Butylochnik/Nedra_Sarai/sarai_v1_content_dxf.odt

# Зміст аркушів креслень

1. Загальний вигляд.
2. Розріз А-А. Фундамент.
3. Розріз А-А. Лицювання фундаменту, відмостка. (немає)
4. Підвал.
5. Покрівна плита підвалу.
6. Оглядова яма.
7. Розріз Б-Б. Низ коробки.
8. Розріз В-В. Середина коробки.
9. Розріз Г-Г. Верх коробки.
10. ЗБ перекриття.
11. Вікно кімнатне звичайне.
12. Вікно кімнатне світлове.
13. Двері кімнатні.
14. Перемичка дверна (розріз).
15. Ворота гаражні.
16. Перемичка воріт (розріз).
17. Загальна перемичка воріт.
18. Армопояс ЗБ перекриття.
19. Арматурні каркаси вікон (додаток до арк. 11, 12).
20. Розрізи армопоясу у різних місцях (додаток до арк. 9).
21. Модифіковані U-блоки.
22. Розрізи армопоясу ЗБ перекриття у різних місцях (додаток до арк. 18).
23. Кроквяна система (розріз).
24. Кроквяна система (план).
25. Крокви (креслення).
26. Фронтон.
27. Вікно дахове.
28. Вікно слухове.
29. Розкладка дощок решетування.
30. Розкладка шиферу.
31. Димар.
