Butylochnik/Nedra_Sarai/sarai_notes.odt

# Кладка

Кладка всіх стін крім перегородки IV виконується з газоблоків AEROC розміром (Д х Ш х В) 60 см х 30 см х 20 см. Кладка перегородки IV виконується з газоблоків AEROC розміром 60 см х 40 см х 20 см.

Зовні стіни лицюються керамічною цеглою стандартних розмірів 25 см х 12,5 см х 6,5 см. Відстань між облицовкою і основною стіною 4,5 см.

Основна стіна і облицовка зв’язуються гнучкими зв’язками, виконаними з металевої оцинкованої штапи завтовшки не менше 0,5 мм і завширшки 5 ... 6 см. Штапи вставляються через кожні 3 ряди кладки основної стіни (60 см) на відстані 80 ... 120 см одна від одної.

Лицювальна цегла вкладається з вентиляційними отворами, виконаними як вертикальні шви, що не заповнені розчином. Кількість вентиляційних отворів 4 ... 5 на 1 м² кладки. Вентиляційні отвори не влаштовуються у 4 верхніх рядах кладки.

У першому ряді лицювальної кладки через кожні 3 цегли робляться дренажні отвори, виконані як вертикальні шви, що не заповнені розчином.

Кути виконуються згідно Малюнок 1. Виступ декоративних кутів і пояска 2...3 см відповідно до розміру декоративної частини цегли.

2..3

A

Вигляд A

Малюнок 1. Виконання кутів.
