Butylochnik/Nedra_Sarai/SolarStation/Nedra_Sarai_SolarStation.odt

# Розрахунок архітектури системи (версія 2)

### Склад:

1. Сонячна батарея Risen RSM40-8-400M (9 шт.);
2. Акумуляторна батарея TOYAMA NPS100-12 (4 шт.);
3. Гібридний інвертор Must Power Systems PH18 MPPT 5048/60A (1 шт.);
4. Пристрій захисту від імпульсних завад ОПС1-С 1P клас II (C), IEK (4 шт.);
5. Автоматичний вимикач ВА47-60 2P 16 А х-ка C, IEK (3 шт.);
6. Автоматичний вимикач ВА47-60 2P 25 А 30 мА хар-ка B тип AC, IEK (1 шт.):
7. Плавка вставка запобіжника ППНИ-33, габарит 00, 160 А, IEK (1 шт);
8. Вимикач-роз'єднувач під запобіжники e.fuse.VR.160, 3P габарит 00, 160А, E.NEXT (1 шт).

### Параметри компонентів:

1. Сонячна батарея (1 модуль):
  1. Макс. потужність, (Вт) 400
  2. Напруга за макс. потужності, (В) 34.39
  3. Струм за макс. потужності, (А) 11.64
  4. Струм к.з., (А) 12.34
  5. Напруга х.х., (В) 41.3
2. Акумуляторна батарея (1 модуль):
  1. Ємність, (А * год) 100
  2. Напруга, (В) 12
  3. Ном. зарядний струм, (А) 10
3. Інверторний модуль:
  1. Макс. потужність сон. панелей, (Вт) 3000
  2. Макс. зарядний струм сон. панелей, (А) 80
  3. Макс. зарядний струм від мережи, (А) 60
  4. Роб. діапазон MPPT PV, (В) 64 ~ 130
  5. Макс. напруга х.х. PV масива, (В) 145

### Архітектура системи.

NPS
100-12

Ext. Line

Int. Line

Fuse 160A

OverC prot.
16A

OverV prot.

OverV prot.

1

4

2

2

2

PH18 MPPT 5048/60A

AC In
~ ~

AC Out
~ ~

ACC
+ -

PV Arr
+ -

3

NPS
100-12

NPS
100-12

NPS
100-12

4

5

6

RSM40-8-400M

OverCprot.
25A

RSM40-8-400M

RSM40-8-400M

RSM40-8-400M

RSM40-8-400M

RSM40-8-400M

RSM40-8-400M

RSM40-8-400M

RSM40-8-400M

8

1. Напруга х.х. на сонячних батареях: 41.3 * 3 = 123.9 < 145.
2. Напруга на сонячних батареях за макс. потужності: 34.39 * 3 = 103.17 < 130.
3. Струм к.з. сонячних батарей: 12.34 * 3 = 37.02; Дріт 8AWG (∅ 3.3, S 8.37 mm²).
4. Струм від сонячних батарей за макс. потужності 11.64 * 3 = 34.92.
5. Максимальна потужність сонячних батарей 400 * 9 = 3600.
6. Струм від акумулятора на номінальній. потужності: (4000 + 50) / 48 = 84.4; Дріт 4AWG (∅ 5.2, S 21.2 mm²).
7. Струм від акумулятора на макс. потужності (5 сек):

(2 * 4000 + 50) / 48 = 167.7

# Проблеми, що можуть виникнути

1. Сонячні панелі можуть намагатися пошкодити, кинувши каміння.
2. Удар блискавки в панелі.

# Комунікація

Відповідь lsusb при підключеному і відключеному інверторі:

butylochnik@john-Inspiron-7347:~$ lsusb

Bus 001 Device 003: ID 0a5c:216a Broadcom Corp.

Bus 001 Device 002: ID 8087:8000 Intel Corp.

Bus 001 Device 001: ID 1d6b:0002 Linux Foundation 2.0 root hub

Bus 003 Device 001: ID 1d6b:0003 Linux Foundation 3.0 root hub

Bus 002 Device 005: ID 04f3:042f Elan Microelectronics Corp.

Bus 002 Device 004: ID 0c45:64cb Microdia

Bus 002 Device 003: ID 0483:91d1 STMicroelectronics Sensor Hub

Bus 002 Device 002: ID 09da:054f A4Tech Co., Ltd.

Bus 002 Device 006: ID 1a86:7523 QinHeng Electronics HL-340 USB-Serial adapter

Bus 002 Device 001: ID 1d6b:0002 Linux Foundation 2.0 root hub

butylochnik@john-Inspiron-7347:~$ lsusb

Bus 001 Device 003: ID 0a5c:216a Broadcom Corp.

Bus 001 Device 002: ID 8087:8000 Intel Corp.

Bus 001 Device 001: ID 1d6b:0002 Linux Foundation 2.0 root hub

Bus 003 Device 001: ID 1d6b:0003 Linux Foundation 3.0 root hub

Bus 002 Device 005: ID 04f3:042f Elan Microelectronics Corp.

Bus 002 Device 004: ID 0c45:64cb Microdia

Bus 002 Device 003: ID 0483:91d1 STMicroelectronics Sensor Hub

Bus 002 Device 002: ID 09da:054f A4Tech Co., Ltd.

Bus 002 Device 001: ID 1d6b:0002 Linux Foundation 2.0 root hub

butylochnik@john-Inspiron-7347:~$

# Перелік робіт

№ | Операція | Матеріали | Інструмент | Ризики і шляхи обходу | ✓
1 | Складання допоміжного трапу. | Дошка 25 × 150 × 4000 1 шт, дошка 25 × 150 × 2000 1 шт, рейка 30 × 30 × 3000 1 шт, мет. кутник 2 шт, шуруп ∅ 5 × 50 100 шт. | Рулетка, дриль, жало-викрутка, пила, викрутка хрестова. | | ✓
2 | Натягування горизонтальних мотузок. | Мотузка, цвяхи. | Рулетка, молоток. | Місце кріплення може не потрапити в дошку. Переконатися, що мотузка йде по центру дошки. | Не робилось
3 | Розмітка місць кріплення кронштейнів. | | Рулетка, крейда.
4 | Свердління отворів під шпильки кронштейнів. Встановлення шпильок і кронштейнів. | Шпилька Шпилька дворізьбова гвинт-шуруп 8x120 16 шт, гайка М8 32 шт, шайба гровера 16 шт, герметик. | Свердла ∅ 8, ∅ 5 (довге), набір торцевих накидних ключів, ріжкові ключі. | | ✓
5 | Свердління отворів під заземлення в рейках. | | Свердло ∅ 8, дриль. | | ✓
6 | Встановлення рейок для сонячних батарей. | | Набір ключів торцевих внутрішніх, мотузка. | Не забути передбачити приєднання заземлення. | ✓
7 | Виготовлення тримачів для батарей | Залізо 2 мм. | Рулетка, болгарка, лещата. | | Не робилось
8 | Виготовлення дротів підключення сонячних батарей і дротів заземлення. | Кабель ∅ 3.3, роз'єми, термозбіжка, олово, каніфоль. | Рулетка, паяльник 100 Вт, викрутка, кусачки. | Перед монтажем другого роз'єму надіті на дріт шматок термоусадки. | ✓
9 | Встановлення сонячних батарей. | Кріплення для батарей, дроти підключення. | Набір ключів торцевих внутрішніх, вольтметр. | Забуті або некоректні з'єднання. Перевірити: з кожного боку до дротів підключення приєднані однакові полюси; всі батареї з'єднані. заземлення підключене до обох рейок. Всі дроти на поверхні даху у пластикових трубках. | ✓
10 | Встановлення розподільчих коробок на даху. | Розподільчі коробки, шурупи | Хрестова викрутка, шило | Одну з коробок треба купити. | ✓
11 | Свердління отворів для дротів підключення до інвертора. | | Перфоратор (дриль), бур (свердло) | | ✓
12 | Виготовлення дротів підключення сонячних батарей до інвертора і дроту заземлення сонячних батарей. | Кабелі S 10, S 6, клеми, термозбіжка, олово, каніфоль. | Рулетка, паяльник 200 Вт, кусачки. | Перед монтажем другого роз'єму надіті на дріт шматок термозбіжки. | ✓
13 | Підключення і прокладка робочих дротів і дроту заземлення. | Гофрована пластикова трубка, гвинти з гайками і шайбами гровера М8, (колодка клемна 10 мм²), хомути. | Гайкові ключі, викрутки. | | ✓
14 | Виготовлення дротів підключення акумулятора до інвертора. | Кабель S 25, клеми, термозбіжка, олово, каніфоль. | Рулетка, паяльник 200 Вт, кусачки. | Перед монтажем другого роз'єму надіті на дріт шматок термозбіжки. Один з дротів має йти через запобіжник. | ✓
15 | Виготовлення тимчасового стелажу для акумуляторів | Рейки, дошки, шурупи. | Пилка, дриль з викруткою. | | ✓
16 | Монтаж інвертора на стіну. | Дюбелі ∅ 10 3 шт, шурупи ∅ 8 3 шт. | Перфоратор, бур, молоток, гайковий ключ. | | ✓
17 | Монтаж кабельних каналів. | Дюбелі ∅ 5, шурупи ∅ 3, кабельний канал. | Перфоратор, бур, молоток, хрестова викрутка. | | ✓
18 | Монтаж коробки для автоматів та ПЗІП | Дюбелі ∅ 8, шурупи ∅ 4, коробка ПЗІП. | Перфоратор, бур, молоток, хрестова викрутка. | | ✓
19 | Монтаж коробки і запобіжника | Дюбелі ∅ 10, шурупи ∅ 6, коробка і кронштейн для запобіжника. | Перфоратор, бур, молоток, хрестова викрутка. | Попередньо коробку підігнати під запобіжник. | ✓
20 | Монтаж та підключення до інвертора акумуляторів. | Дроти, запобіжник. | Гайковий ключ. | Перевірити полярність. Дроти пропустити через кришку інвертора. | ✓
21 | Монтаж та підключення до інвертора і батарей автоматів та ПЗІП. | Дроти. | Хрестова викрутка, паяльник, олово, каніфоль. | | ✓
22 | Підключення до інвертора заземлення. | | Хрестова викрутка. | | ✓
23 | Перевірка працездатності системи. | Розетка-подовжувач. | Хрестова викрутка, тестер. | Перевірка роботи: лампочки, холодильника, чайника. | ✓

# Комерційні данні

# Висновки

- Систему було запущено у використання 10/08/23.
- Спочатку було підключено інвертор разом із акумуляторами до зовнішньої і внутрішньої мереж. В такому режимі інвертор використовувався як UPS починаючи з грудня 2022. Вже в липні було монтовано батареї і підключено до інветора.
- Всі роботи монтажу рейок і дротів велися безпосередньо з підставленої до краю даху драбини а потім із вже встановлених рейок.
- Підйом батарей на дах здійснювався по 2х рейках, з’єднаних між собою. Рейки використовував довжиною близько 6 м, що забезпечило легкий підйом батарей.
- Верхній ряд батарей монтувався з нижніх рейок. Для монтажу нижнього ряду у верхній частині рейок прикрутив горизонтальний трап, по якому пересувався коли виставляв батарею.
- В самих батареях, які ставив у нижній ряд, вкрутив у верхній частині з кожного боку по гвинту (отвори в батареях вже були). Після підйому батарея цими гвинтами чіплялась до верхньої монтажної планки. Це дозволило легко переміщатися в нижню частину батареї після її підйому.
- Для приєднання до батарей на поверхні даху використав спеціальний дріт KBE solar 4 мм². Решту розводки робив кабелем ПВ-3 10 мм². Для заземлення використав ПВ-3 6 мм².
- Автомати відключення батарей так само як і ПЗІПи було встановлено на даху. Через необхідність захисту як плюса так і мінуса сонячного масиву було використано двох полюсні автомати біля інвертора встановлено автомат (теж двох полюсний) відключення від мережі і відповідні ПЗІПи.

# Розрахунок потужності для зварювального апарату

1. Максимальна потужність (ККД = 0.95):
  1. 150 * 26 / 0.95 = 4.1 кВт.
  2. Це відповідає мережевому струму 150 * 26 / (0.95 * 220) = 18.7 А.

# Спостереження за роботою системи

Майже одразу після встановлення сонячних батарей помітив аномальну поведінку системи — інвертор регулярно клацав якоюсь релюхою. Визначити причину такої аномалії довго не вдавалося. На початку 06.2024 з'ясував, що один з акумуляторів вийшов з ладу — напруга на ньому в режимі заряджання могла сягати 18 В, а під навантаженням могла падати до 6 В. Замінив цей акумулятор на автомобільний і система повернулася до нормального стану. Отже замовив аналогічний за параметрами акумулятор https://mega-teplo.com.ua/ua/p1979176844-gelevij-akumulyator-toyama.html і 09.06.24 ввів в експлуатацію.

Максимальний струм, який інвертор подає для зарядки акумуляторів, виглядає суттєво завищеним — 60 А проти 30 А, на які розраховані акумулятори. Експериментально встановив, що цим струмом опікується параметр за номером 02 у списку параметрів інвертора. Встановив його на рівні 10 А (1/10 від ємності акумулятора).

Виглядає так, що параметр за номером 47 у списку параметрів сонячного перетворювача не має відношення до струму зарядки батарей а визначає максимальний струм, який видаватиме цей блок на внутрішню шину.

Подальші спостереження показали, що параметр 02 визначає не тільки струм заряду батарей але (так само як і параметр 47) й той струм, який сонячний перетворювач видає на внутрішню шину. Отже щоб відбирати максимальну енергію від батарей потрібно цей параметр встановити на рівні 60 або, навіть, 70 А. Так і не зрозумілим залишається чим тоді обмежувати максимальний зарядний струм батарей?

Купив додатково 4 акумулятори такого самого типу, як встановив 09.06.24: https://toyama.com.ua/product/toyama-npg-100a-12v-gel/. Сконструював полицю для 8 акумуляторів (https://github.com/Butylochnik/Misc_Const/blob/main/Stoika_akumiv.dxf) і 16.07.24 підключив паралельно 2 гірлянди по 4 акумулятори збільшивши ємність батареї до 200 Аг. Також в параметрах інвертора поміняв ємність акумулятора на 200 Аг.
