Butylochnik/Nedra_Sarai/Sarai/sarai_chronicle.odt

21.10.20 Сьогодні розпочали будівництво. Розмітили і на 20 см прокопали майбутній фундамент. Забудовник — Сашко Кіндратюк з Березані (тел. +380 97 340 40 85).

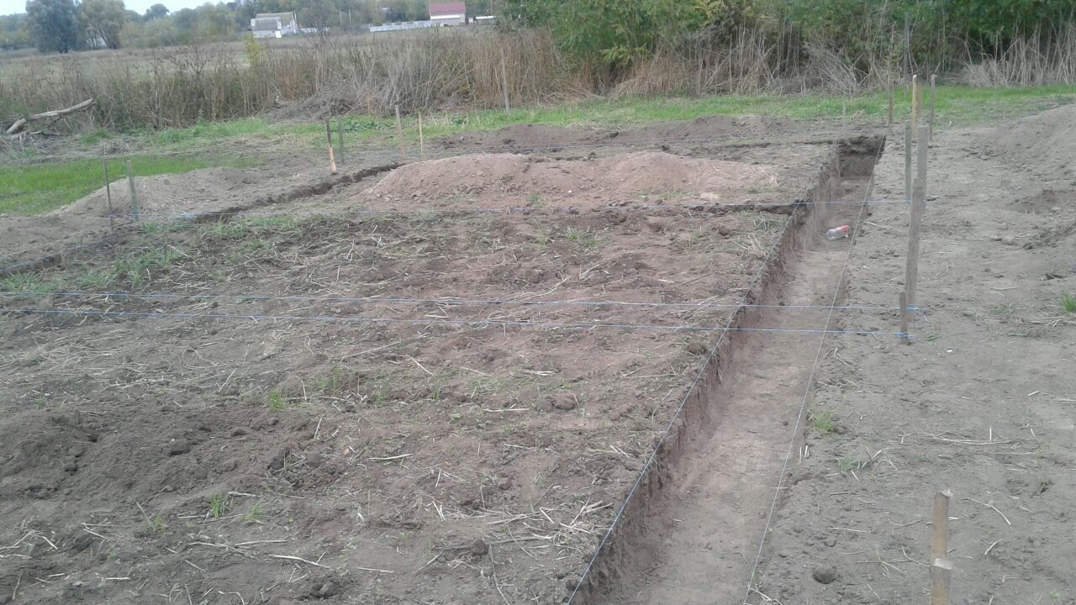
[picture p1: figure]
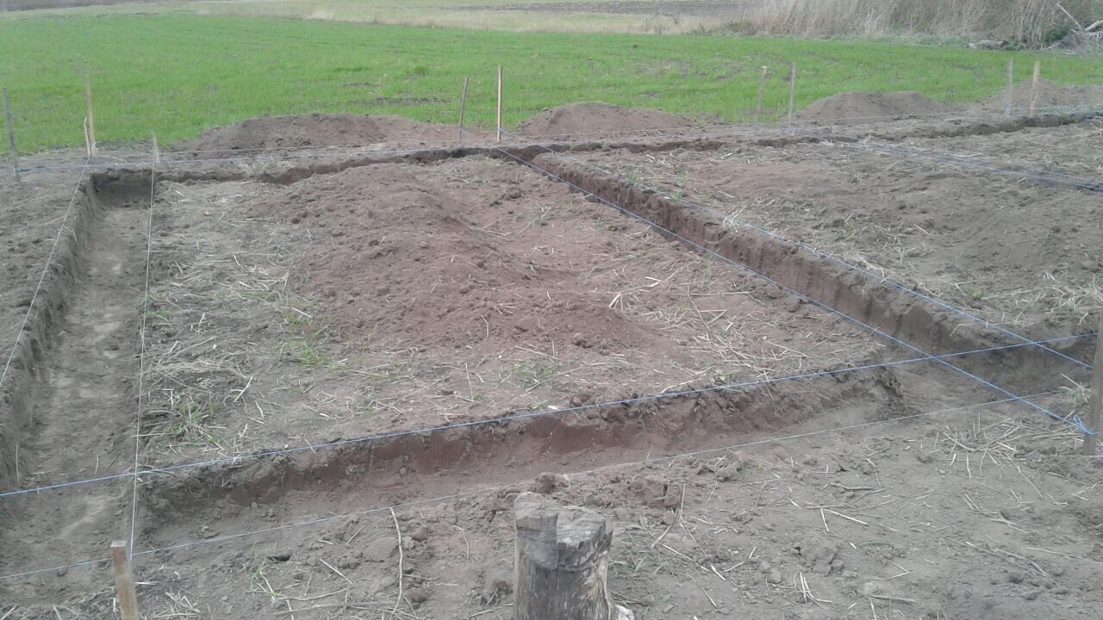
[picture p2: figure]

23.10.20 Закінчили копати траншею під фундамент. Траншея глибиною скрізь 1 м від поверхні.

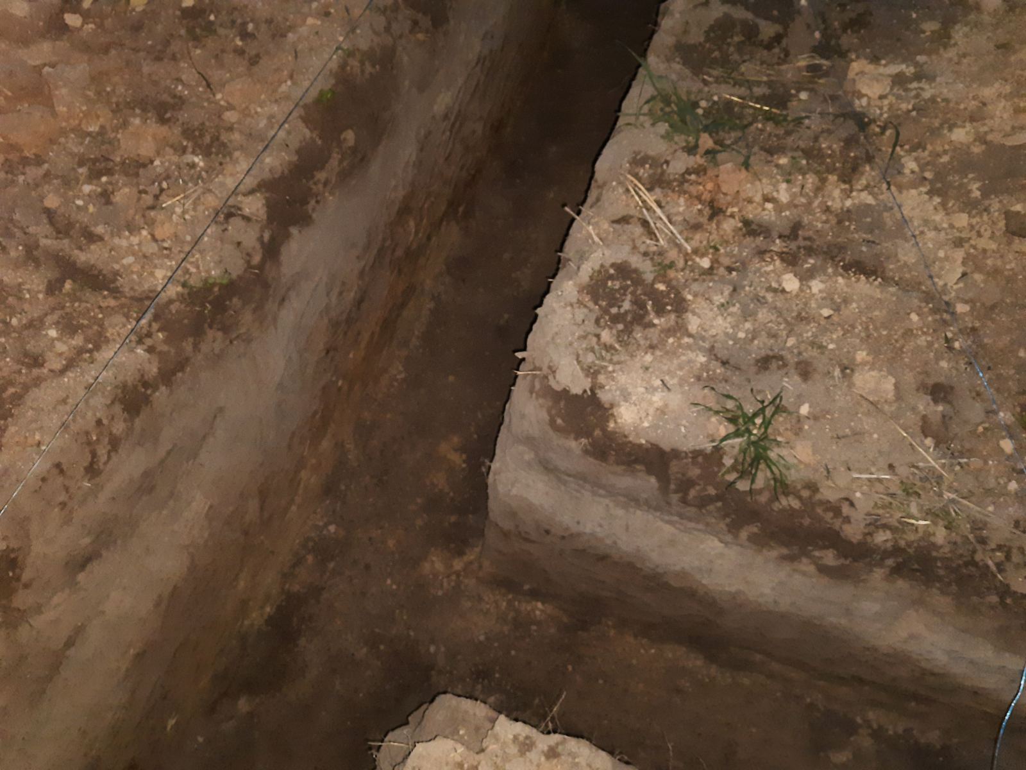
[picture p3: figure]
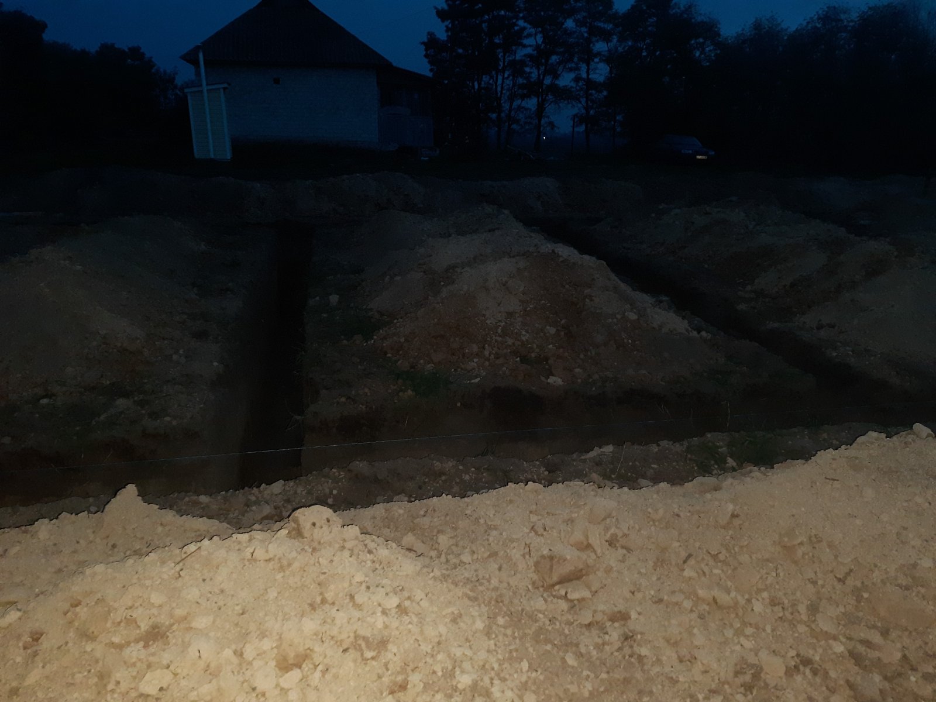
[picture p4: figure]
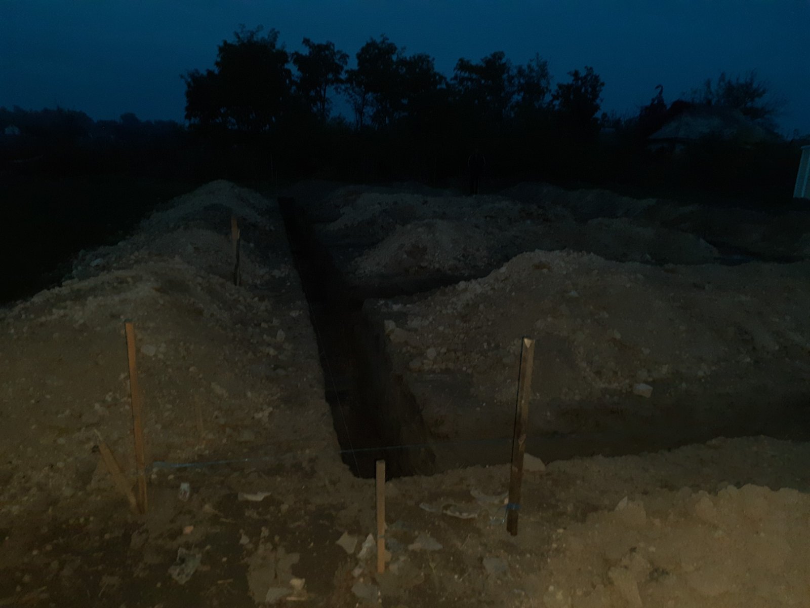
[picture p5: figure]
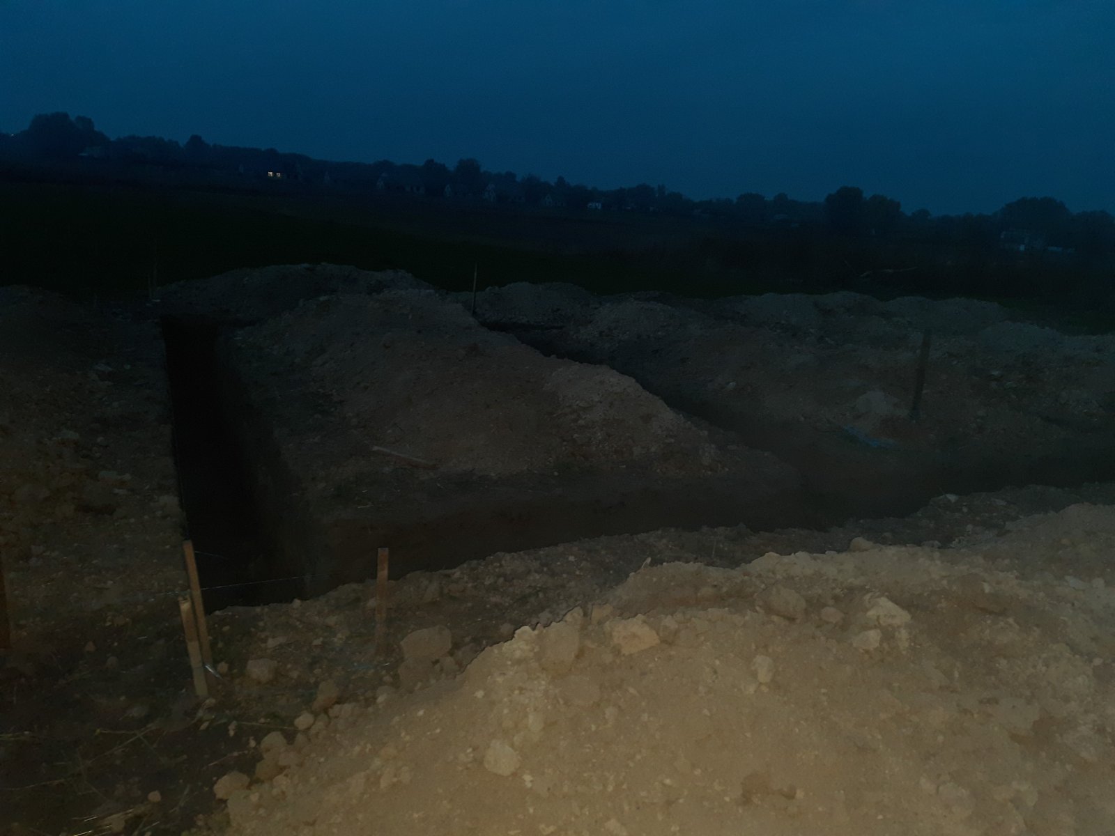
[picture p6: figure]

24.10.20 Розрахувався за земляні роботи (10000 грн), дав аванс на арматуру (20000 грн).

26.10.20 Завезли арматуру, дріт, відрізні круги. За арматуру і дріт заплатив 18405 грн і за доставку 600 грн. За круги заплатив 473 грн. Разом 19478 грн. 525 грн Сашко віддав здачу. Дав аванс 5000 грн на можливі додаткові витрати.

30.10.20 Заклали у траншею під фундамент арматуру. Знизу стрижні діаметром 12 мм, решта — 10 мм.

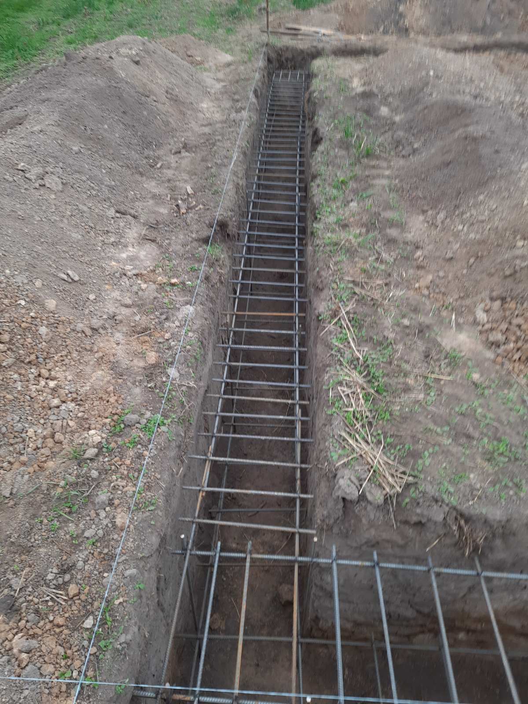
[picture p7: figure]
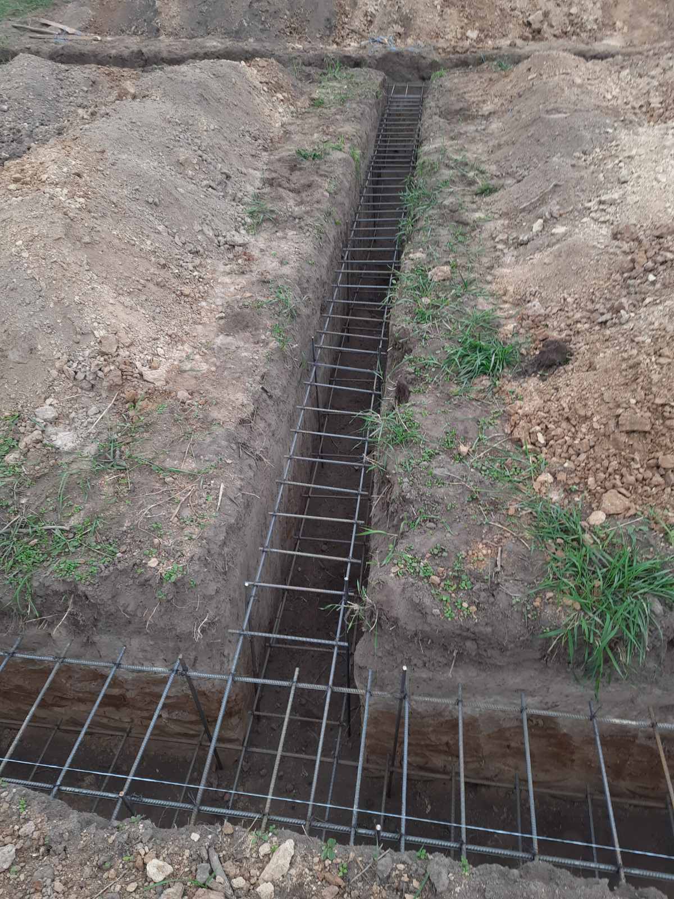
[picture p8: figure]
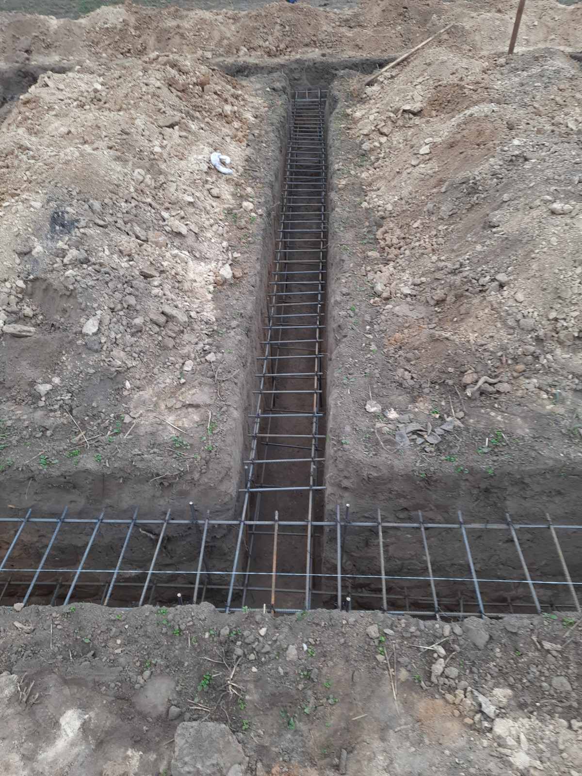
[picture p9: figure]
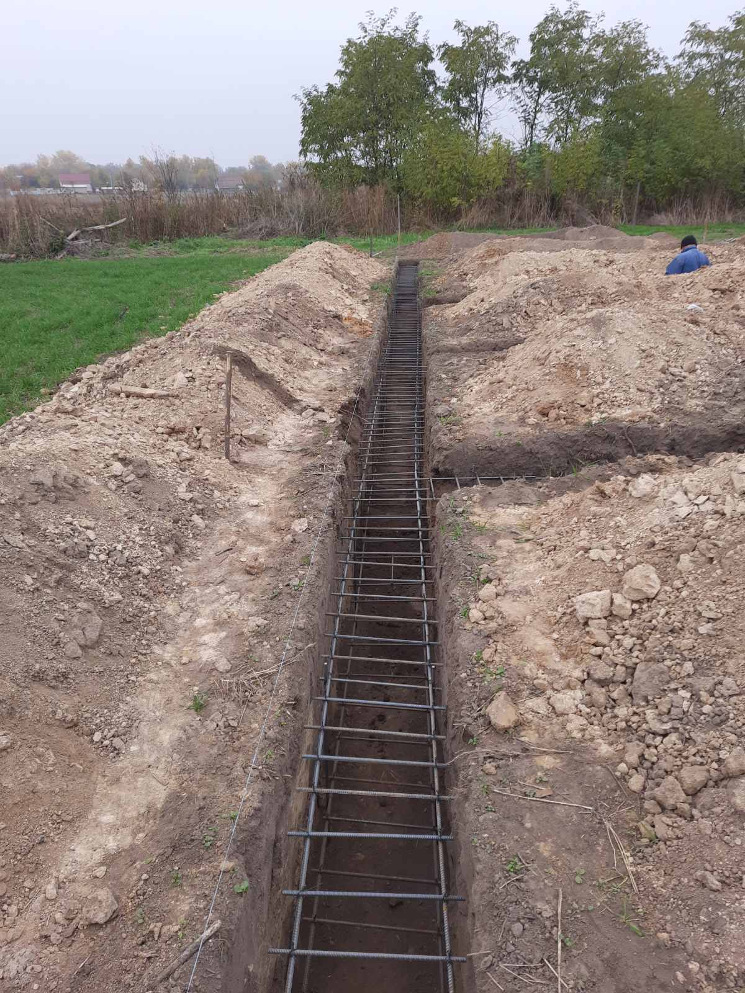
[picture p10: figure]
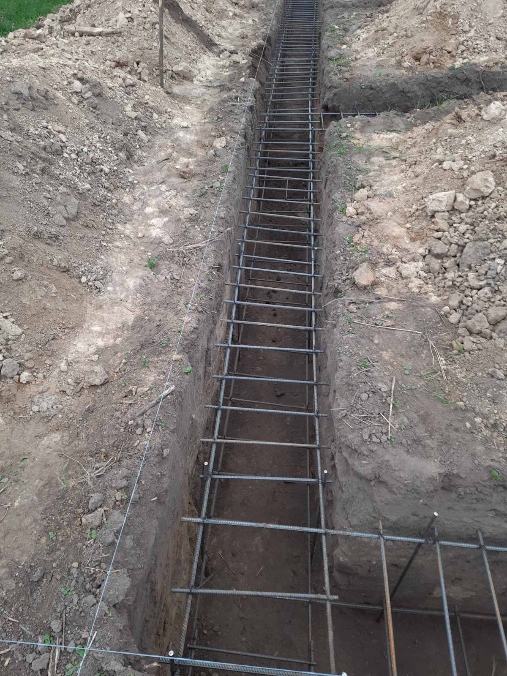
[picture p11: figure]
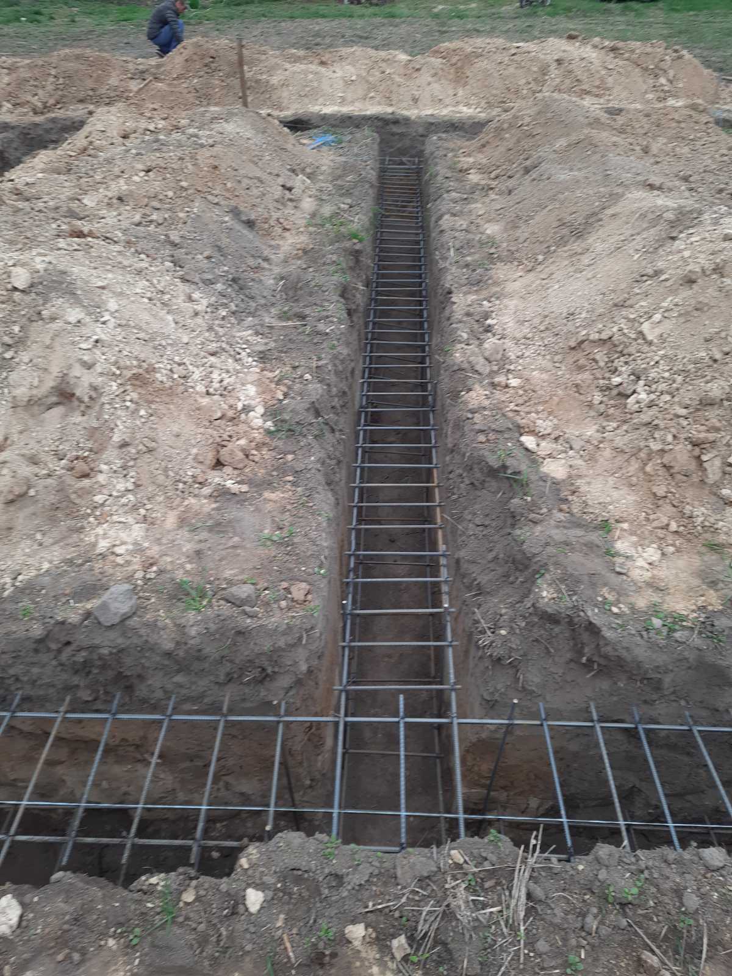
[picture p12: figure]
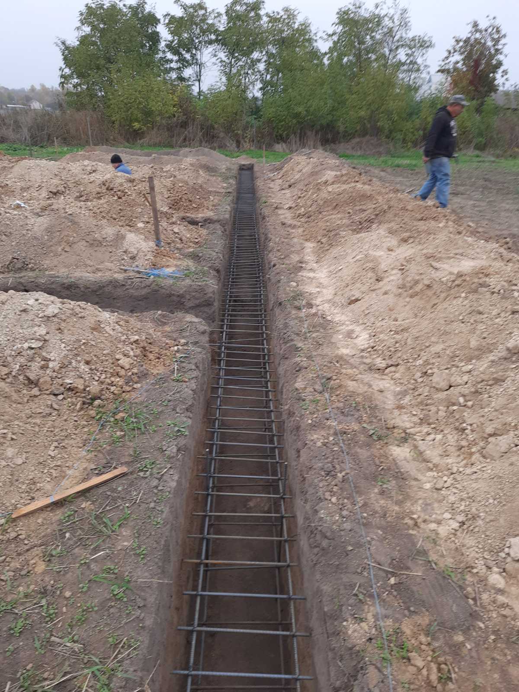
[picture p13: figure]
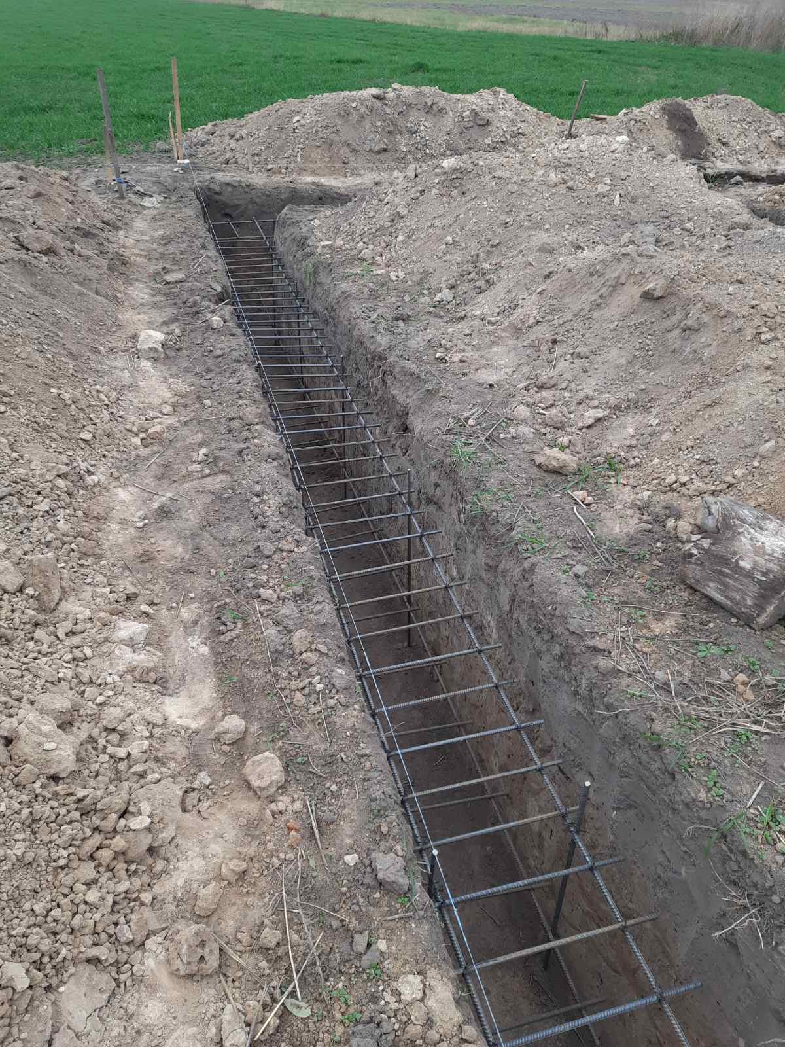
[picture p14: figure]
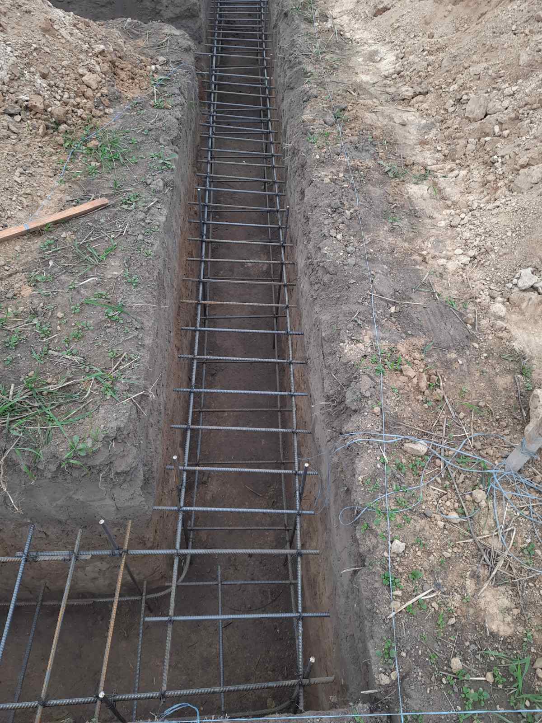
[picture p15: figure]

30.10.20 Проплатив за 35 м³ 81817,68 грн АТ ЗЗБК ім. Ковальської. Замовлення оформлювала менеджер Юлія Каменєва (098 458 78 32). Диспетчер 044 500 01 20.

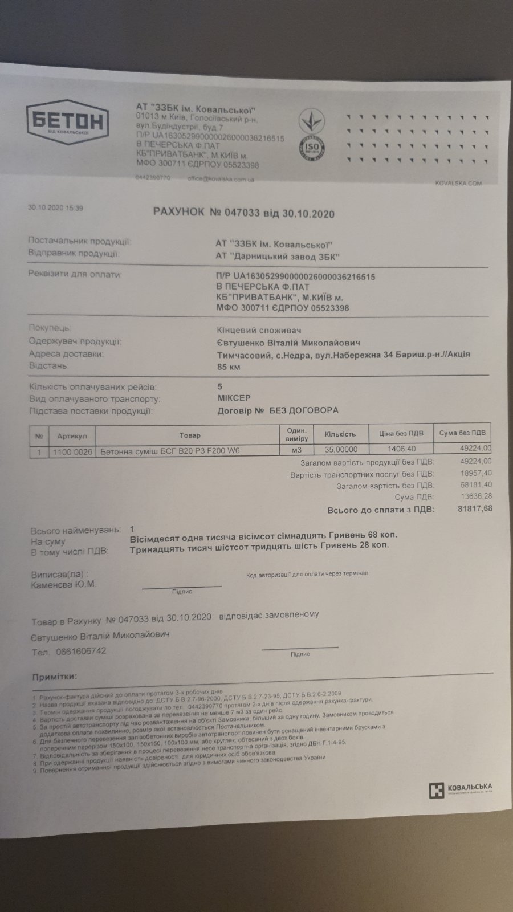
[picture p16: figure]

31.10.20 З 9:00 почали укладку бетону. Закінчили о 14:00. Заповнили всю підземну частину стрічки. Роботу виконували вчотирьох. За бетоноукладальні роботи і в'язку арматури заплатив 40000 грн. готівкою. Ще 4000 грн. перерахував разом із авансом на опалбку (18000 грн.) на картку Сашковій матері (5168 7573 6493 4911 Кіндратенко Валентина Василіївна). Сашко повернув залишок авансу (4314), наданого йому минулого разу 686 грн. було витрачено на додатковий дріт).

14.11.20 Декілька днів тому (~ 11.11.20) почали робити опалубку. На сьогодні вона була закінчена на ~ 80%. З авансу на матеріали для опалубки було витрачено на дошки 13700 грн., на саморізи, кутники, цвяхи 1130 грн. Залишок 3170 грн. Сашко віддав. На можливі додаткові витрати залишив йому 3000 грн.
