Butylochnik/Nedra_Sarai/Sarai/sarai_v1_p_c.dxf

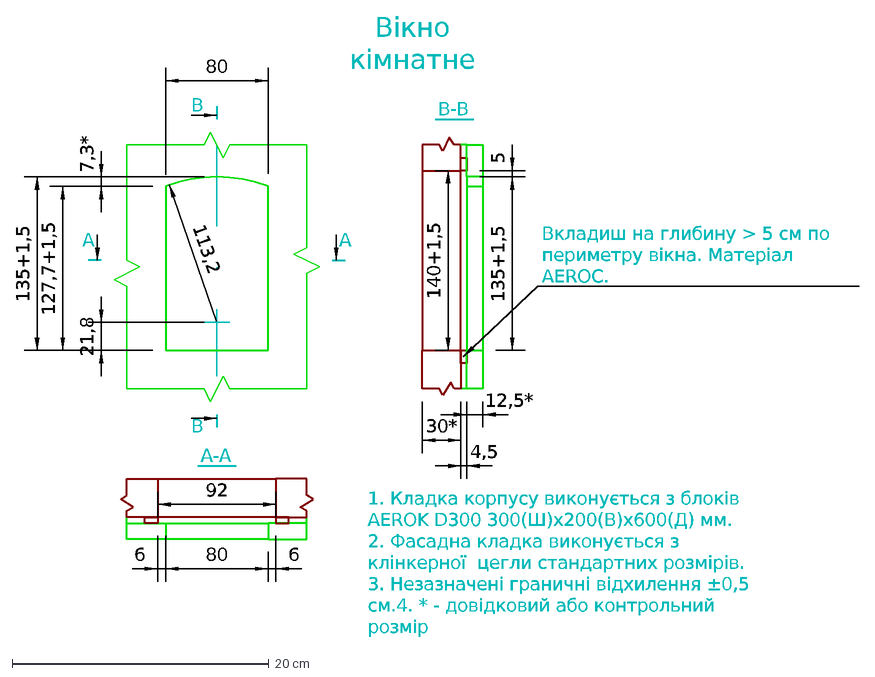
[picture p17: CAD file, 2021-07-02]
Sarai/sarai_v1_p_c.dxf
A
B
80
113,2
21,8
A-A
B-B
4,5
92
Вiкно кiмнатне
140+1,5
135+1,5
127,7+1,5
12,5*
30*
6
5
7,3*
1. Кладка корпусу виконується з блокiв AEROK D300 300(Ш)х200(В)х600(Д) мм. 2. Фасадна кладка виконується з клiнкерної цегли стандартних розмiрiв. 3. Незазначенi
Вкладиш на глибину > 5 см по периметру вiкна. Матерiал AEROC.
