Butylochnik/Nedra_Sarai/SolarStation/solar_bat_placement.dxf

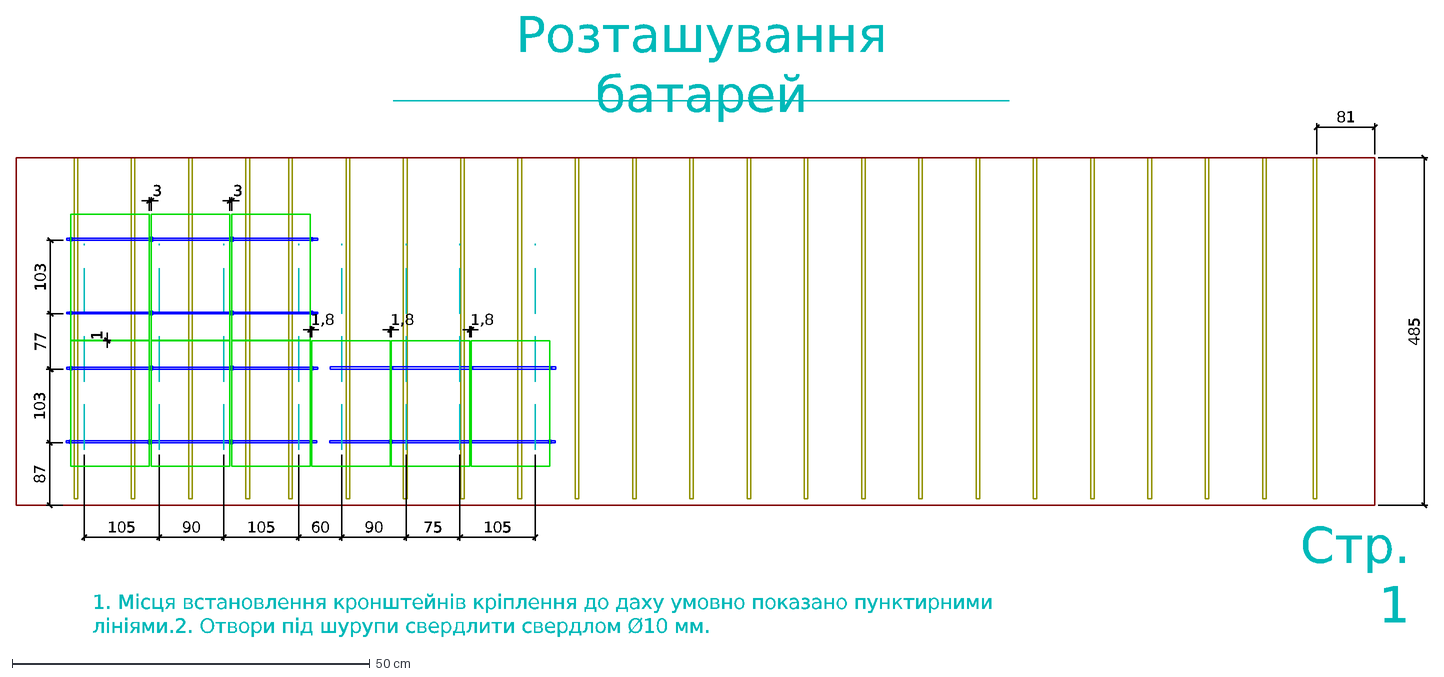
[picture p18: CAD file, 2023-08-13]
SolarStation/solar_bat_placement.dxf
81
Розташування батарей
485
105
90
60
87
103
77
75
Стр. 1
1. Місця встановлення кронштейнів кріплення до даху умовно показано пунктирними лініями. 2. Отвори під шурупи свердлити свердлом Ø10 мм.
3
1,8
1
