Butylochnik/Nedra_Sarai/Sarai/sarai_v1_p_d.dxf

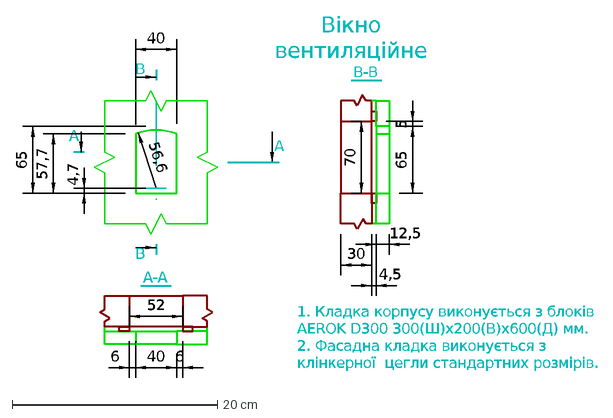
[picture p19: CAD file, 2021-06-30]
Sarai/sarai_v1_p_d.dxf
12,5
30
4,5
6
1. Кладка корпусу виконується з блокiв AEROK D300 300(Ш)х200(В)х600(Д) мм. 2. Фасадна кладка виконується з клiнкерної цегли стандартних розмiрiв.
B
A-A
52
40
A
57,7
B-B
70
65
5
56,6
4,7
Вiкно вентиляцiйне
