Butylochnik/Nedra_Sarai/sarai_vorota_p5.dxf

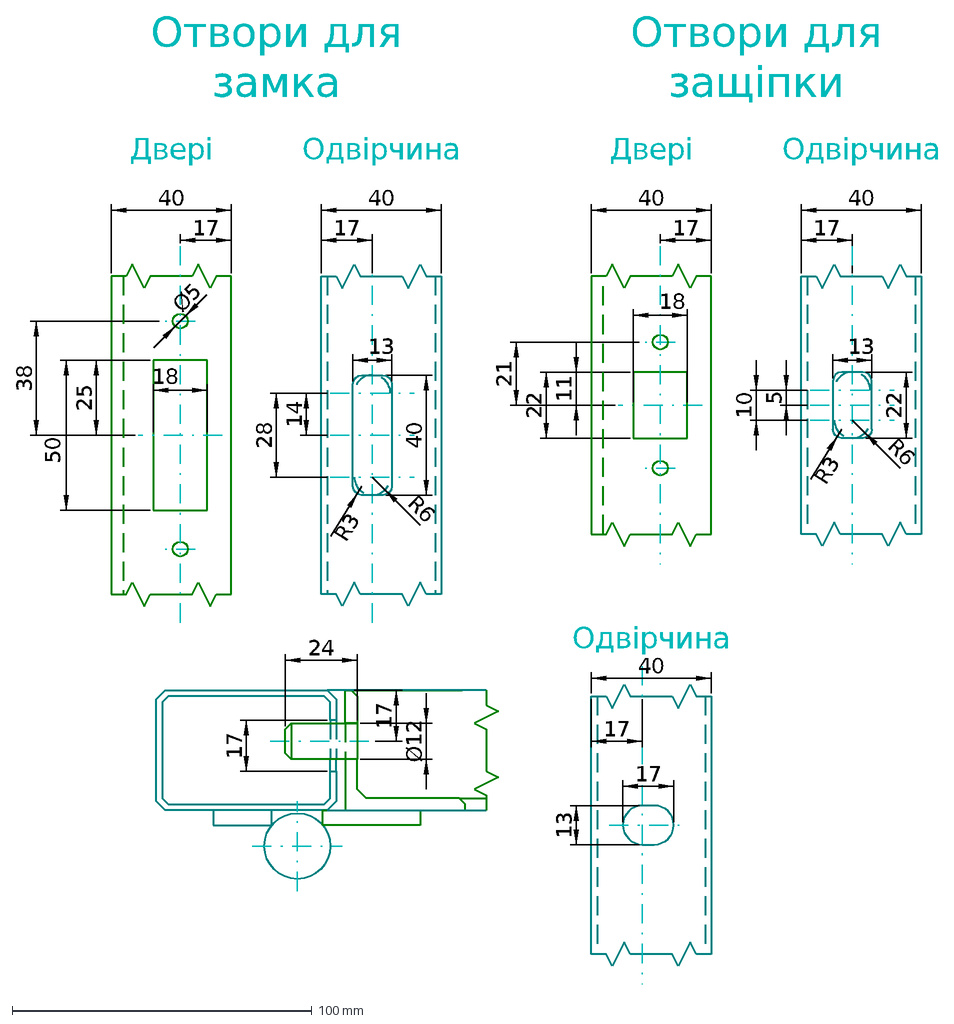
[picture p20: CAD file, 2024-12-03]
sarai_vorota_p5.dxf
17
40
38
18
25
50
Ø12
24
11
22
21
Одвірчина
13
14
28
10
5
R3
R6
Двері
Отвори для защіпки
Отвори для замка
Ø5
