Butylochnik/Nedra_Sarai/Sarai/sarai_v1_px.dxf

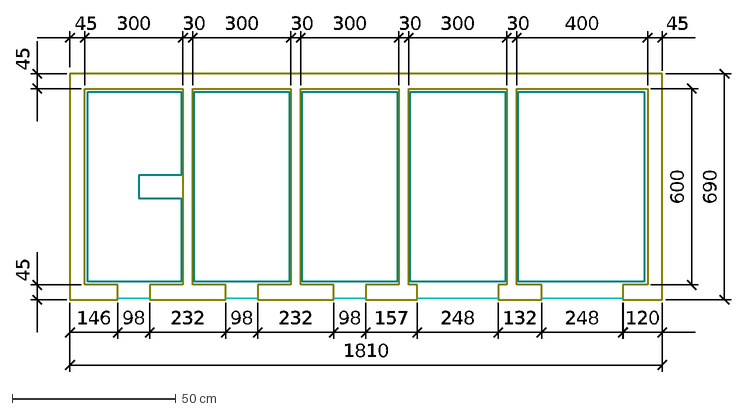
[picture p21: CAD file, 2021-05-05]
Sarai/sarai_v1_px.dxf
45
98
248
1810
600
690
146
232
157
132
120
30
300
400
