Butylochnik/Nedra_Sarai/Sarai/sarai_v1_p3.dxf

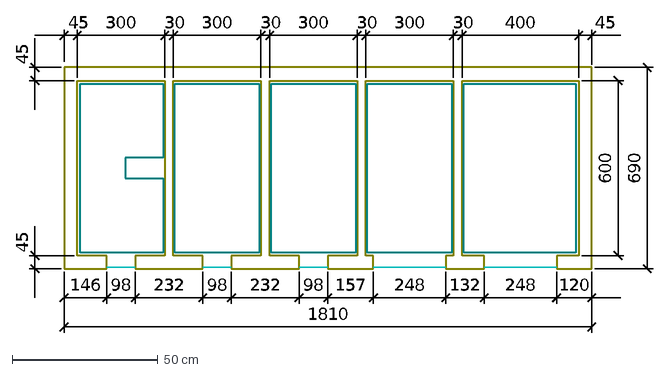
[picture p22: CAD file, 2020-10-27]
Sarai/sarai_v1_p3.dxf
45
98
248
1810
600
690
146
232
157
132
120
30
300
400
