Butylochnik/Nedra_Sarai/sarai_vorota_p8.dxf

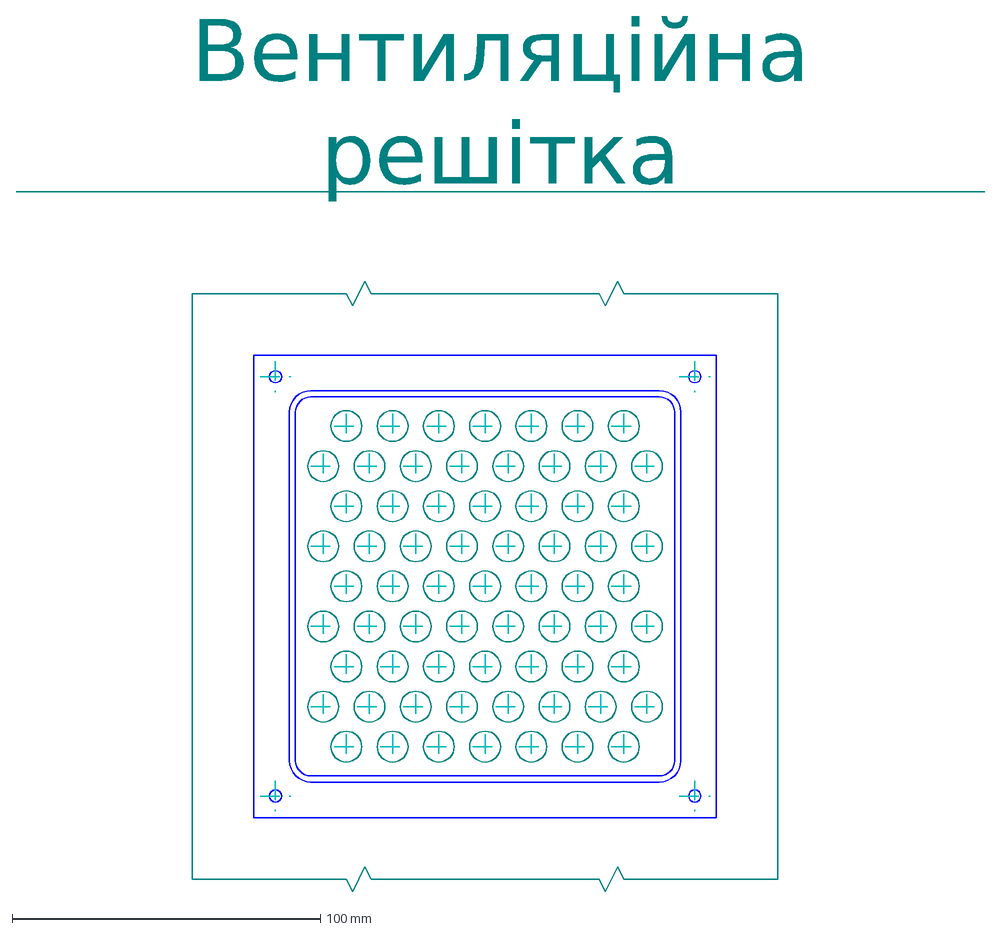
[picture p23: CAD file, 2024-12-03]
sarai_vorota_p8.dxf
Вентиляційна решітка
