Butylochnik/Nedra_Sarai/sarai_vorota_p7.dxf

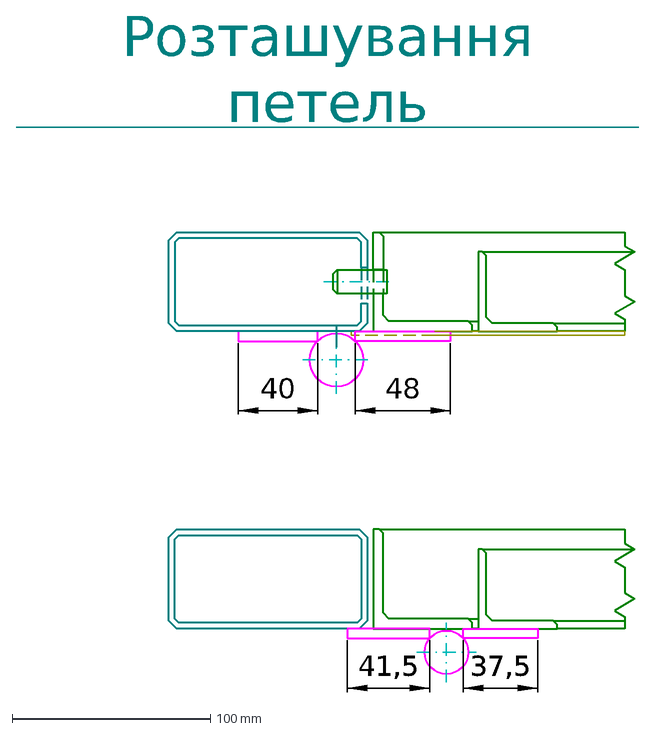
[picture p24: CAD file, 2024-12-03]
sarai_vorota_p7.dxf
40
48
41,5
37,5
Розташування петель
