Butylochnik/Nedra_Sarai/sarai_vorota_p2.dxf

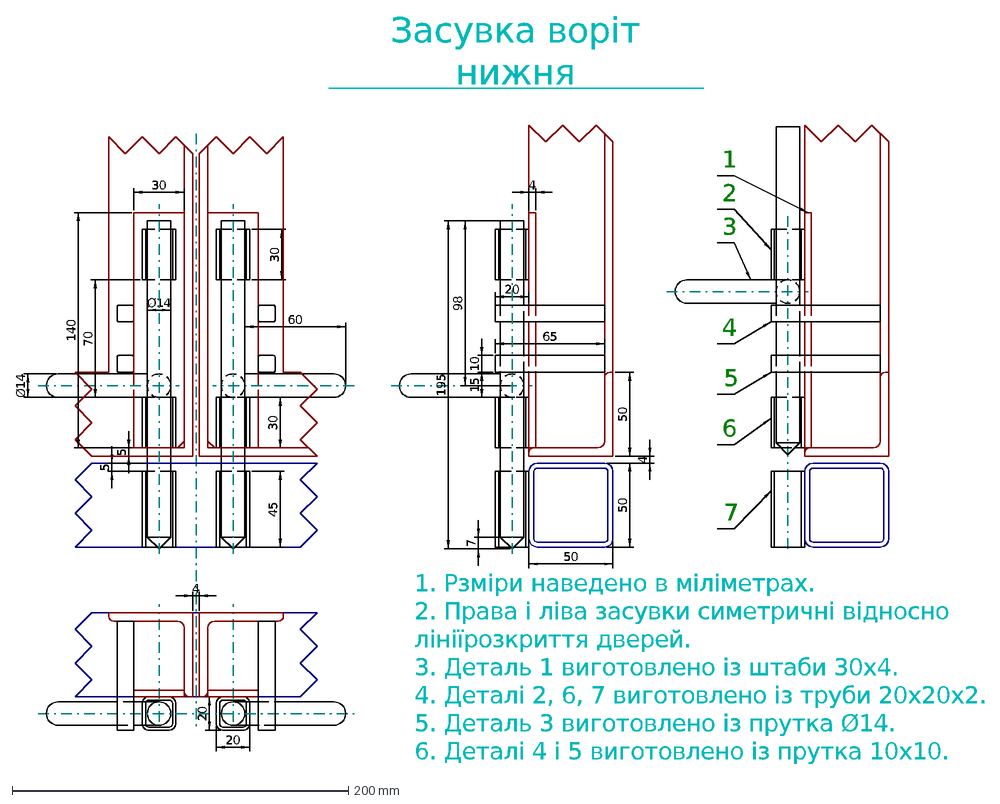
[picture p25: CAD file, 2024-12-03]
sarai_vorota_p2.dxf
20
7
70
30
60
Ø14
45
50
10
15
195
5
65
Засувка ворiт нижня
4
140
1
2
3
6
1. Рзмiри наведено в мiлiметрах. 2. Права i лiва засувки симетричнi вiдносно лiнiї розкриття дверей. 3. Деталь 1 виготовлено iз штаби 30х4. 4. Деталi 2, 6, 7 ви
98
