Butylochnik/Nedra_Sarai/sarai_vorota_p4.dxf

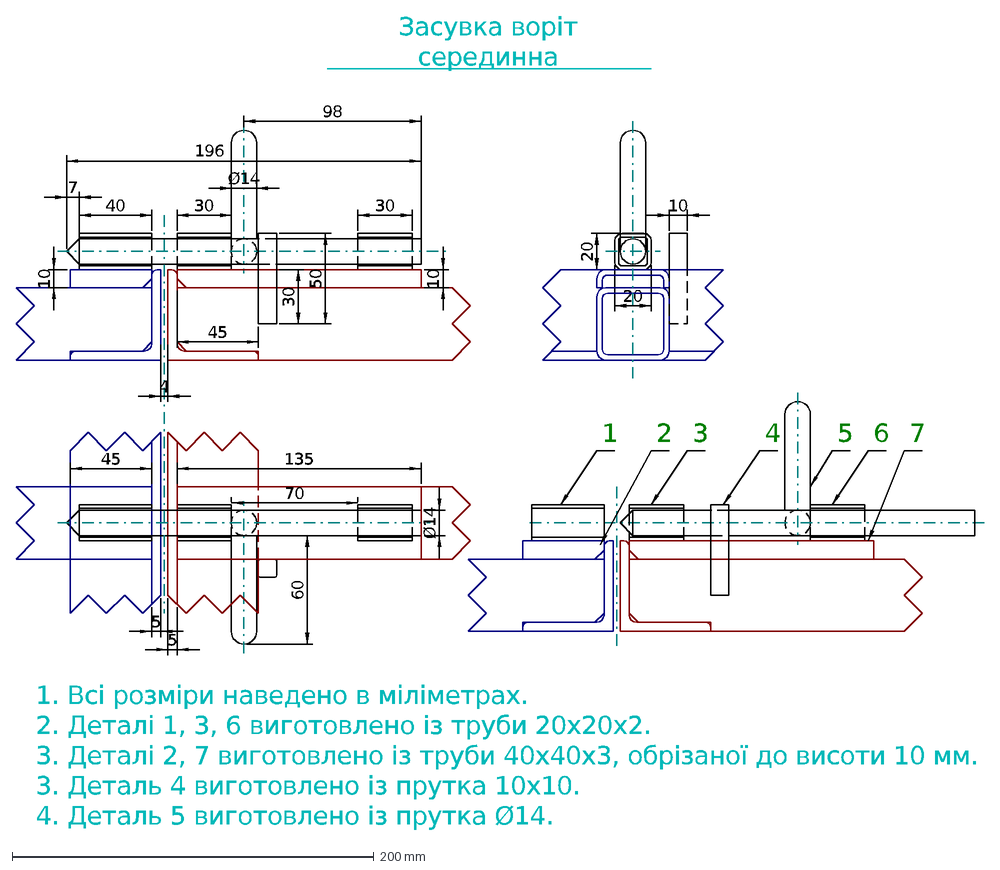
[picture p26: CAD file, 2024-12-03]
sarai_vorota_p4.dxf
30
10
20
60
1
Ø14
40
5
7
45
135
70
98
196
4
50
2
3
6
Засувка ворiт серединна
1. Всi розмiри наведено в мiлiметрах. 2. Деталi 1, 3, 6 виготовлено iз труби 20х20х2. 3. Деталі 2, 7 виготовлено iз труби 40х40х3, обрізаної до висоти 10 мм. 3.
