Butylochnik/Nedra_Sarai/sarai_vorota_p3.dxf

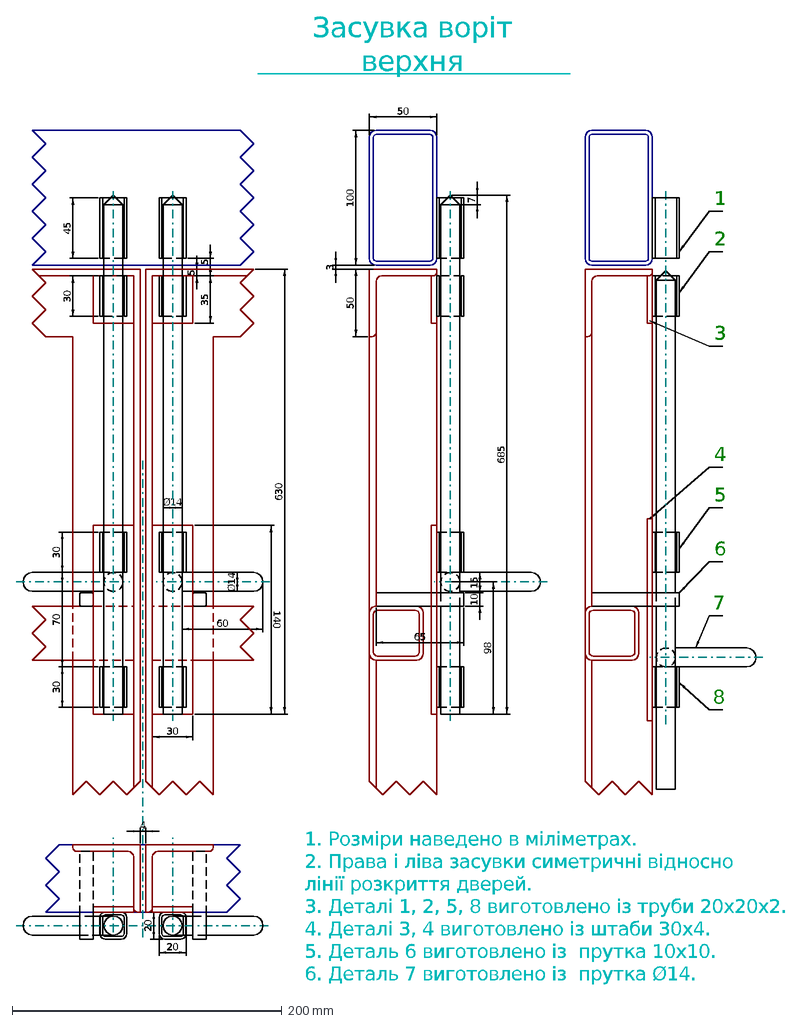
[picture p27: CAD file, 2024-12-03]
sarai_vorota_p3.dxf
20
4
30
70
60
Ø14
10
15
98
65
140
5
6
7
8
1
2
50
100
3
35
630
685
45
Засувка ворiт верхня
1. Розмiри наведено в мiлiметрах. 2. Права i лiва засувки симетричнi вiдносно лiнiї розкриття дверей. 3. Деталi 1, 2, 5, 8 виготовлено iз труби 20х20х2. 4. Дета
