Butylochnik/Nedra_Sarai/sarai_dveri_kimnaty_p1.dxf

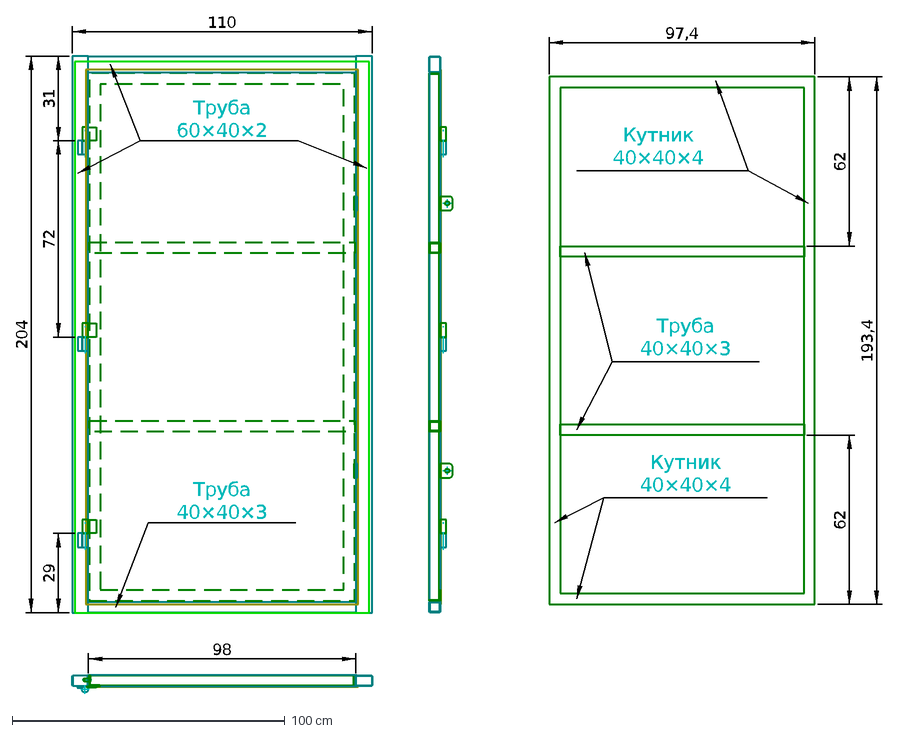
[picture p28: CAD file, 2024-12-03]
sarai_dveri_kimnaty_p1.dxf
98
110
31
29
204
97,4
62
193,4
Труба 40×40×3
Труба 60×40×2
Кутник 40×40×4
72
