Butylochnik/Nedra_Sarai/sarai_vorota_p6.dxf

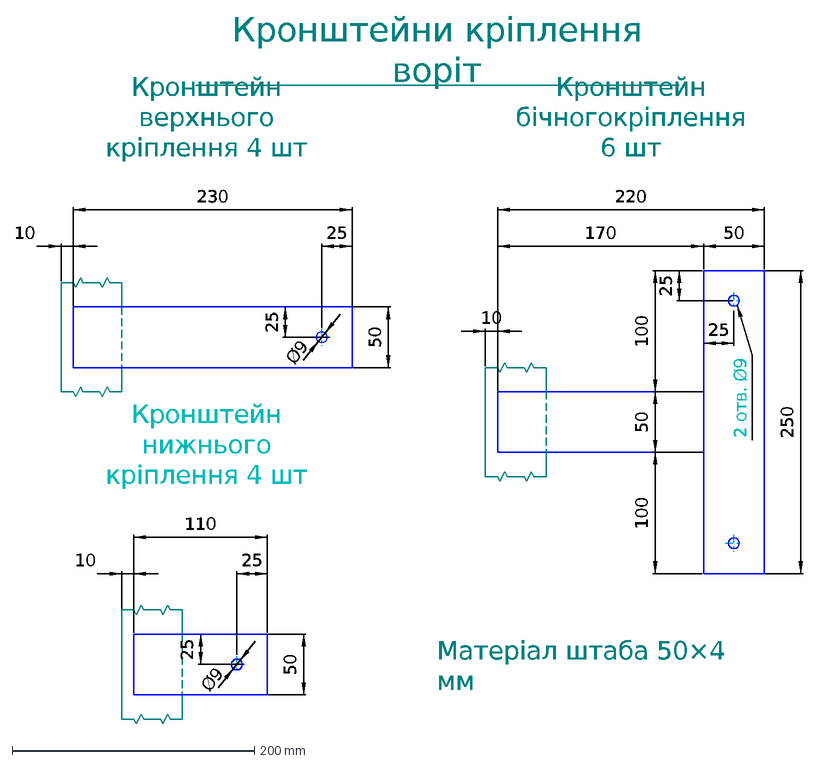
[picture p29: CAD file, 2024-12-03]
sarai_vorota_p6.dxf
10
25
Ø9
50
230
Кронштейн верхнього кріплення 4 шт
Кронштейн нижнього кріплення 4 шт
110
170
100
250
Кронштейн бічного кріплення 6 шт
220
Кронштейни кріплення воріт
Матеріал штаба 50×4 мм
2 отв. Ø9
