Butylochnik/Nedra_Sarai/sarai_v1_p23.dxf

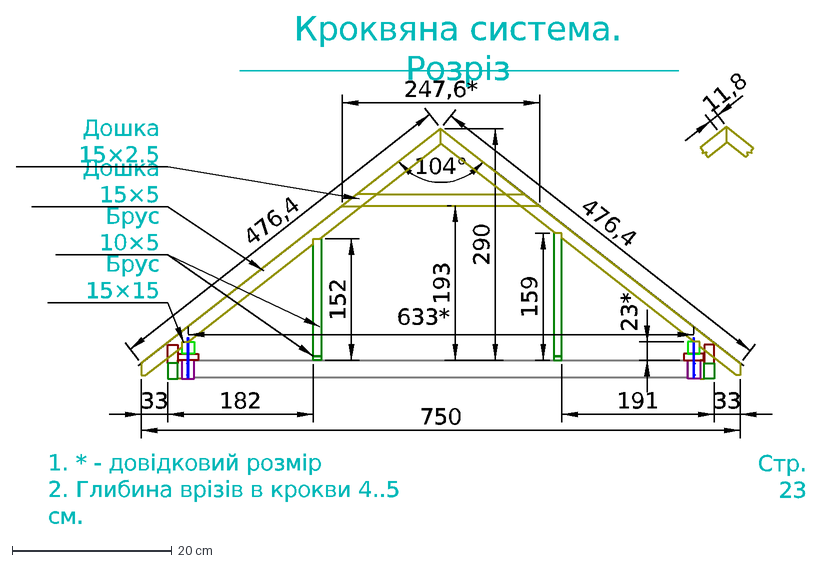
[picture p30: CAD file, 2023-08-13]
sarai_v1_p23.dxf
104°
Кроквяна система. Розріз
476,4
290
193
33
191
182
159
152
247,6*
11,8
Брус 15×15
Брус 10×5
Дошка 15×5
Дошка 15×2.5
633*
23*
750
1. * - довiдковий розмiр 2. Глибина врізів в крокви 4..5 см.
Стр. 23
