Butylochnik/Nedra_Sarai/sarai_gratka_kimnaty.dxf

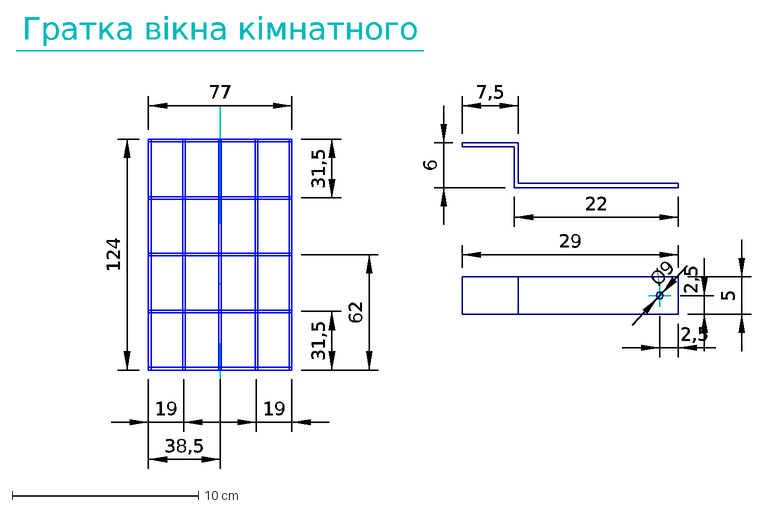
[picture p31: CAD file, 2022-11-16]
sarai_gratka_kimnaty.dxf
Гратка вікна кімнатного
77
19
31,5
124
62
38,5
6
Ø9
7,5
22
29
2,5
5
