Butylochnik/Nedra_Sarai/sarai_v1_pb.dxf

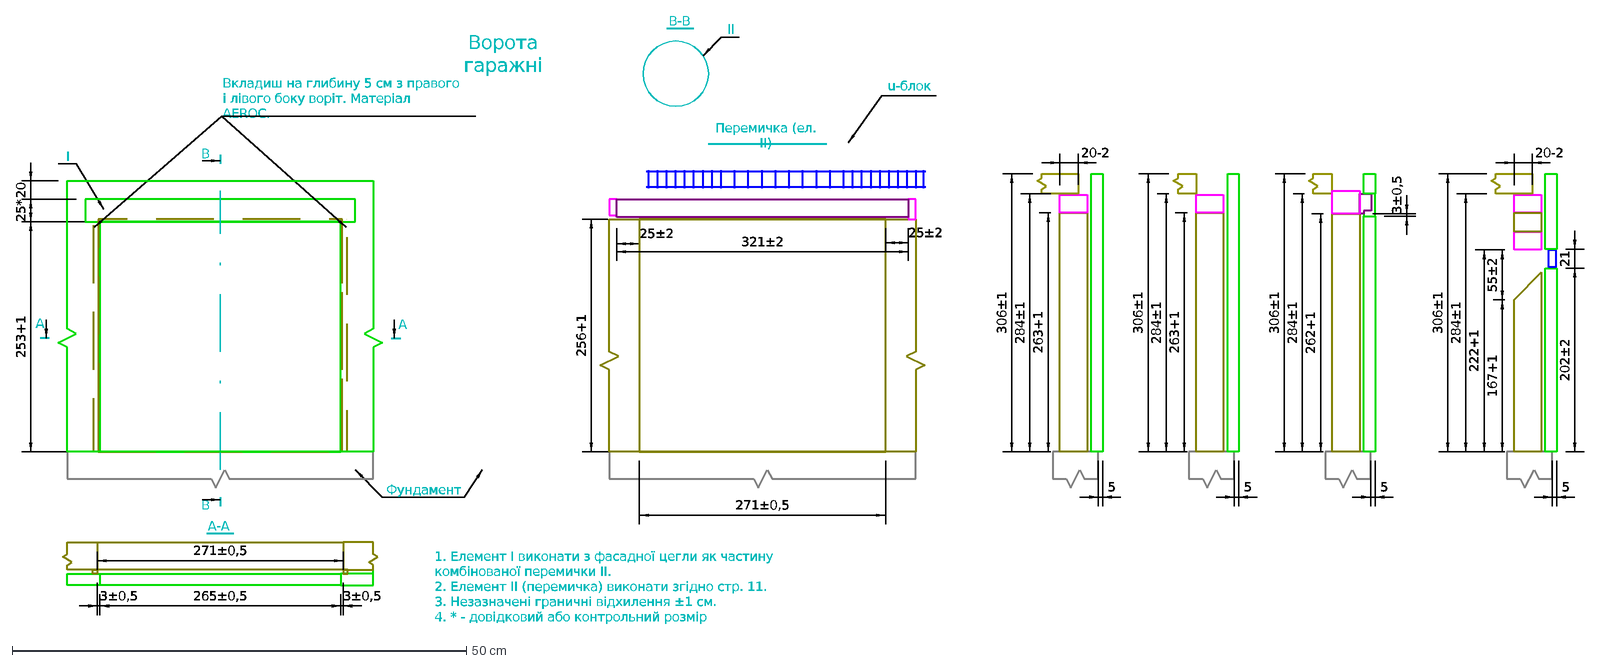
[picture p32: CAD file, 2022-11-16]
sarai_v1_pb.dxf
265±0,5
Фундамент
3±0,5
271±0,5
A
B
A-A
Вкладиш на глибину 5 см з правого i лiвого боку ворiт. Матерiал AEROC.
Перемичка (ел. II)
1. Елемент I виконати з фасадної цегли як частину комбiнованої перемички II. 2. Елемент II (перемичка) виконати згiдно стр. 11. 3. Незазначенi граничнi вiдхилен
Ворота гаражнi
B-B
II
256+1
25±2
321±2
25*
I
253+1
20
u-блок
20-2
306±1
284±1
263+1
262+1
5
222+1
21
167+1
202±2
55±2
