Butylochnik/Nedra_Sarai/sarai_dveri_kimnaty_p2.dxf

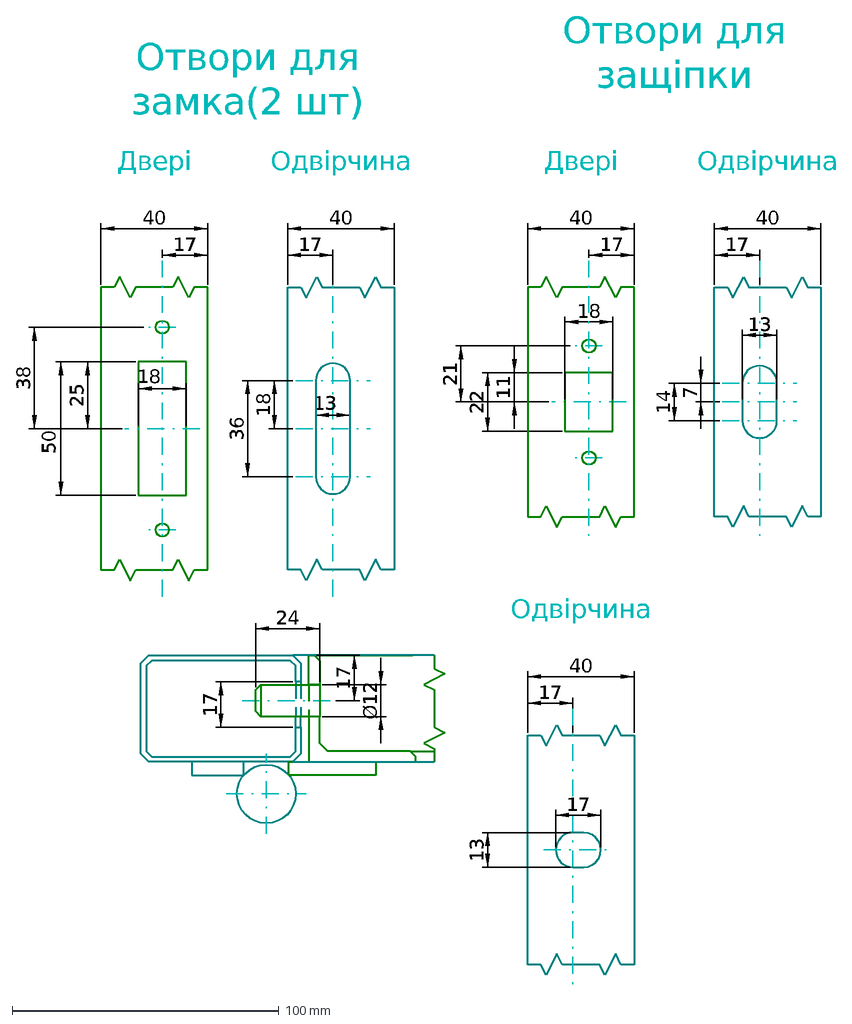
[picture p33: CAD file, 2022-11-16]
sarai_dveri_kimnaty_p2.dxf
17
40
38
18
13
25
50
Двері
Одвірчина
Отвори для защіпки
Отвори для замка (2 шт)
Ø12
24
11
22
21
7
14
36
