Butylochnik/Nedra_Sarai/sarai_vikno_kimnaty.dxf

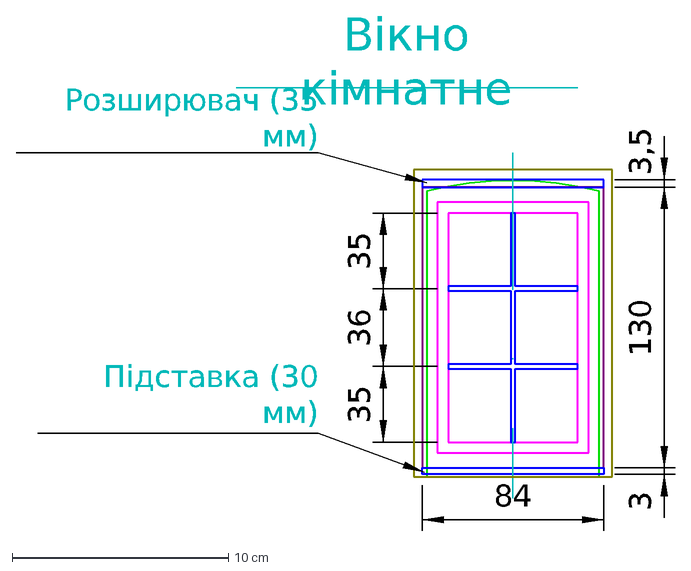
[picture p34: CAD file, 2022-11-16]
sarai_vikno_kimnaty.dxf
84
35
36
130
3,5
3
Розширювач (35 мм)
Підставка (30 мм)
Вікно кімнатне
