Butylochnik/Nedra_Sarai/sarai_v1_p13.dxf

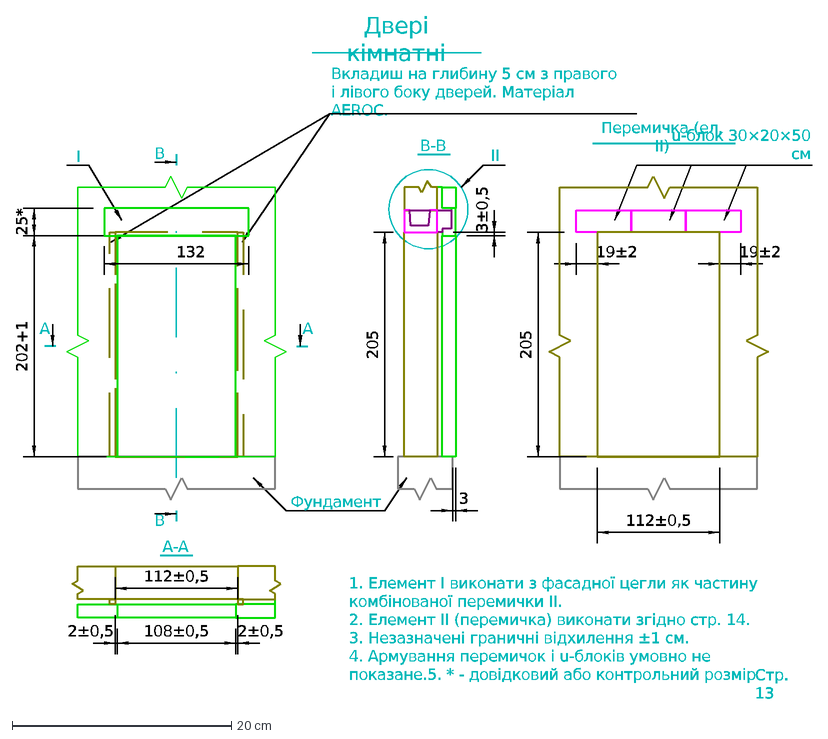
[picture p35: CAD file, 2022-11-16]
sarai_v1_p13.dxf
A-A
2±0,5
108±0,5
112±0,5
A
B
Фундамент
3
Дверi кiмнатнi
Вкладиш на глибину 5 см з правого i лiвого боку дверей. Матерiал AEROC.
Перемичка (ел. II)
B-B
3±0,5
II
I
19±2
205
202+1
u-блок 30×20×50 см
1. Елемент I виконати з фасадної цегли як частину комбiнованої перемички II. 2. Елемент II (перемичка) виконати згiдно стр. 14. 3. Незазначенi граничнi вiдхилен
Стр. 13
25*
132
