Butylochnik/Nedra_Sarai/sarai_v1_p22.dxf

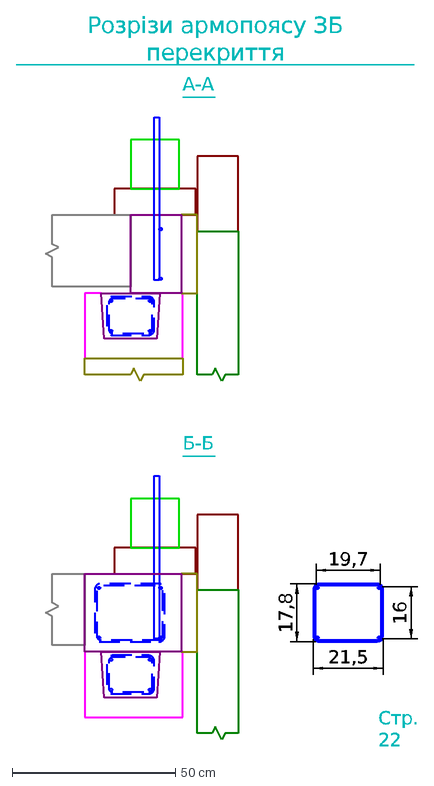
[picture p36: CAD file, 2022-11-16]
sarai_v1_p22.dxf
Розрізи армопоясу ЗБ перекриття
А-А
Б-Б
Стр. 22
16
17,8
21,5
19,7
