Butylochnik/Nedra_Sarai/pechka.dxf

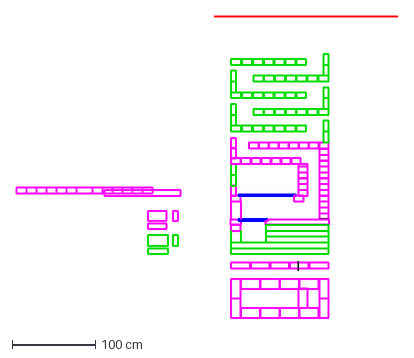
[picture p37: CAD file, 2022-11-16]
pechka.dxf
457.5 x 361.5 cm
