Butylochnik/Nedra_Sarai/sarai_dveri_dahovi_p1.dxf

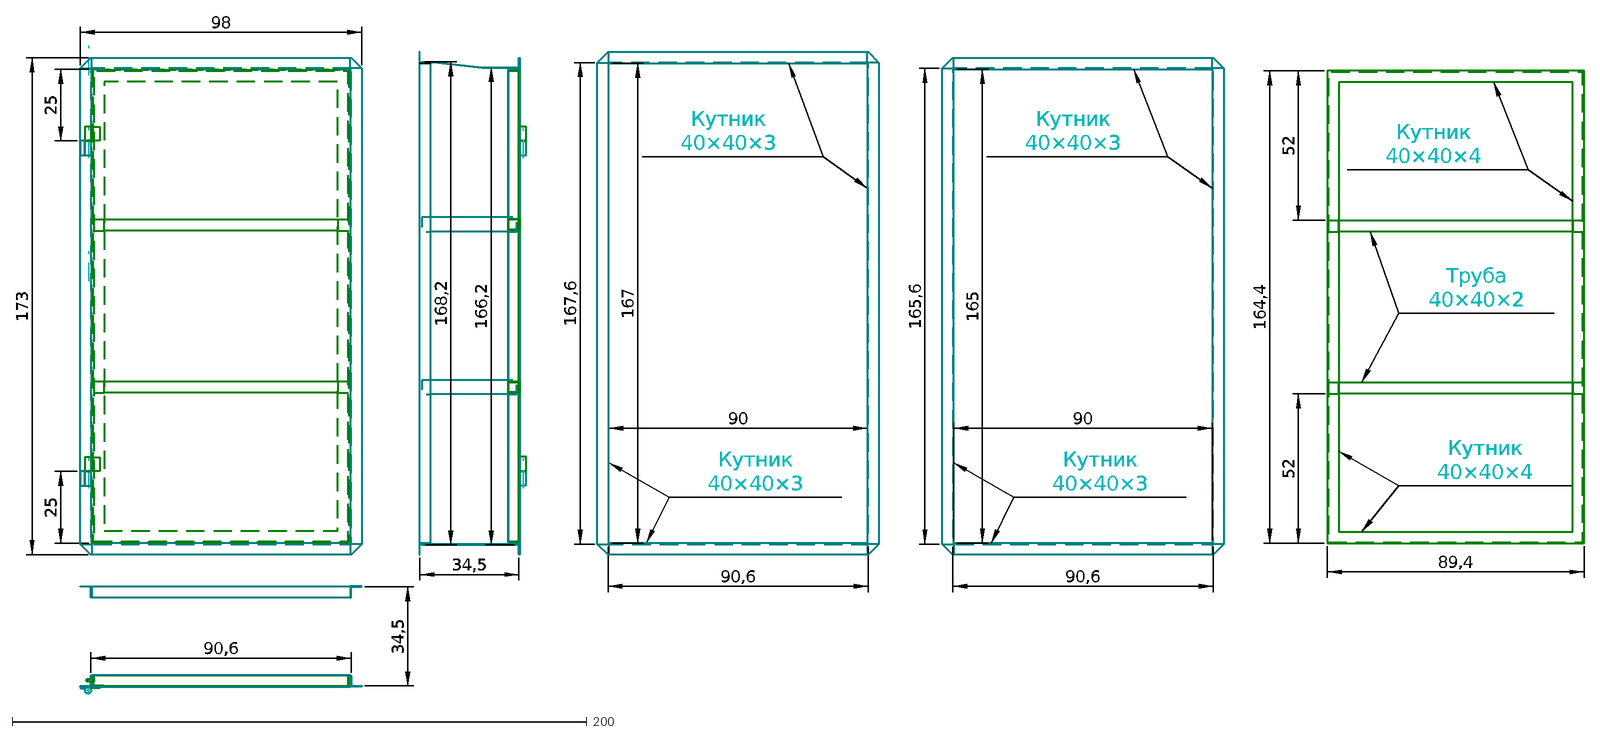
[picture p38: CAD file, 2022-11-16]
sarai_dveri_dahovi_p1.dxf
165,6
89,4
164,4
52
Труба 40×40×2
Кутник 40×40×4
Кутник 40×40×3
165
90,6
34,5
90
25
173
98
166,2
168,2
167,6
167
