Butylochnik/Nedra_Sarai/sarai_vorota.dxf

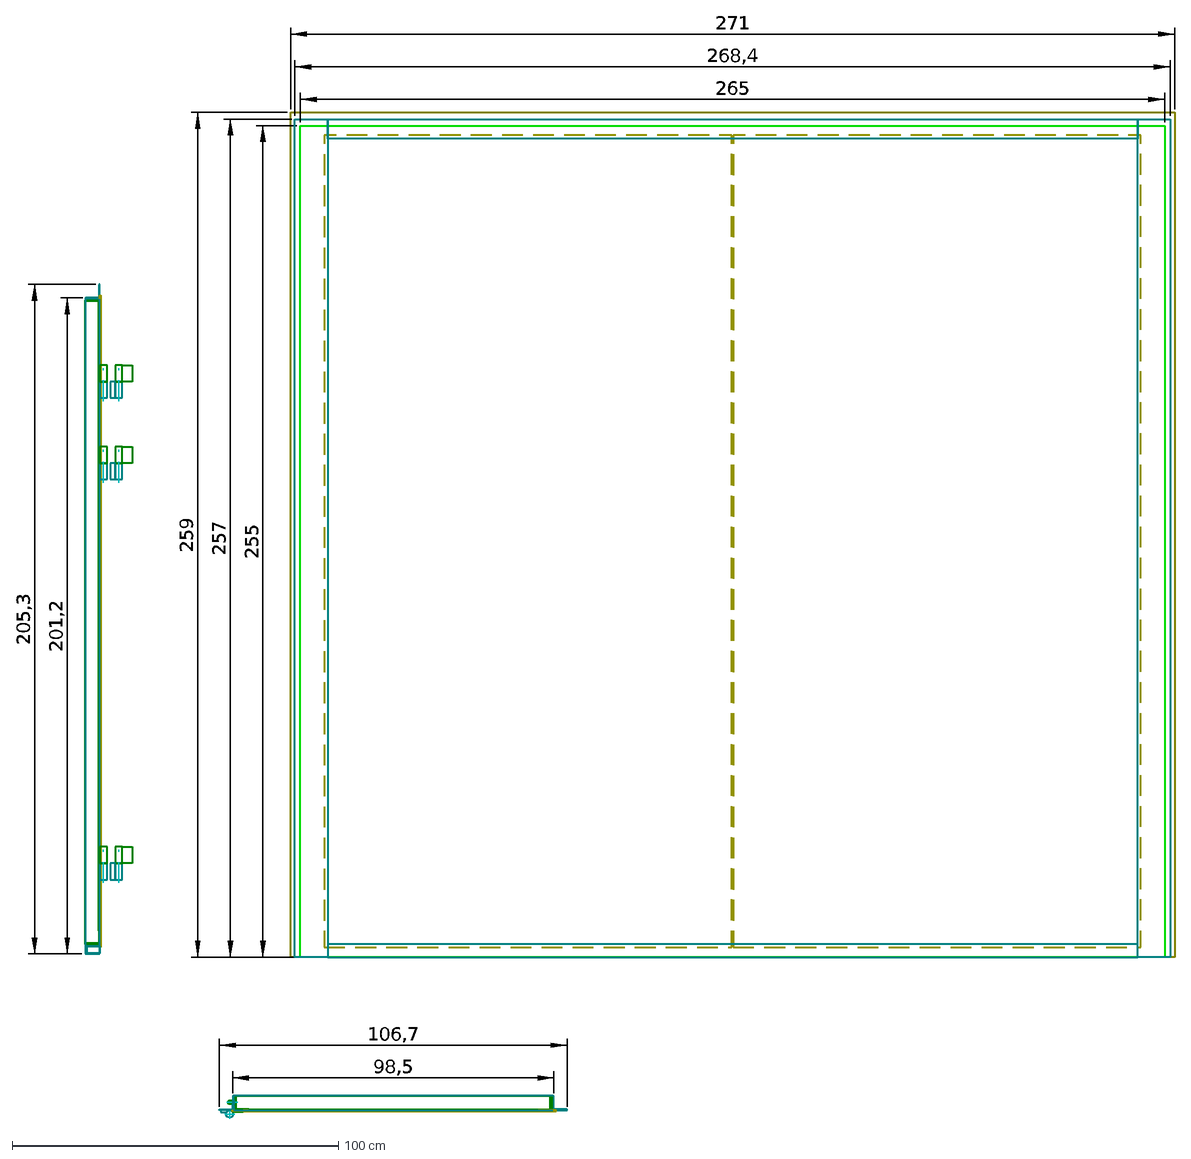
[picture p39: CAD file, 2022-11-16]
sarai_vorota.dxf
201,2
205,3
98,5
106,7
271
259
255
257
268,4
265
