Butylochnik/Nedra_Sarai/sarai_dveri_kimnaty_p3.dxf

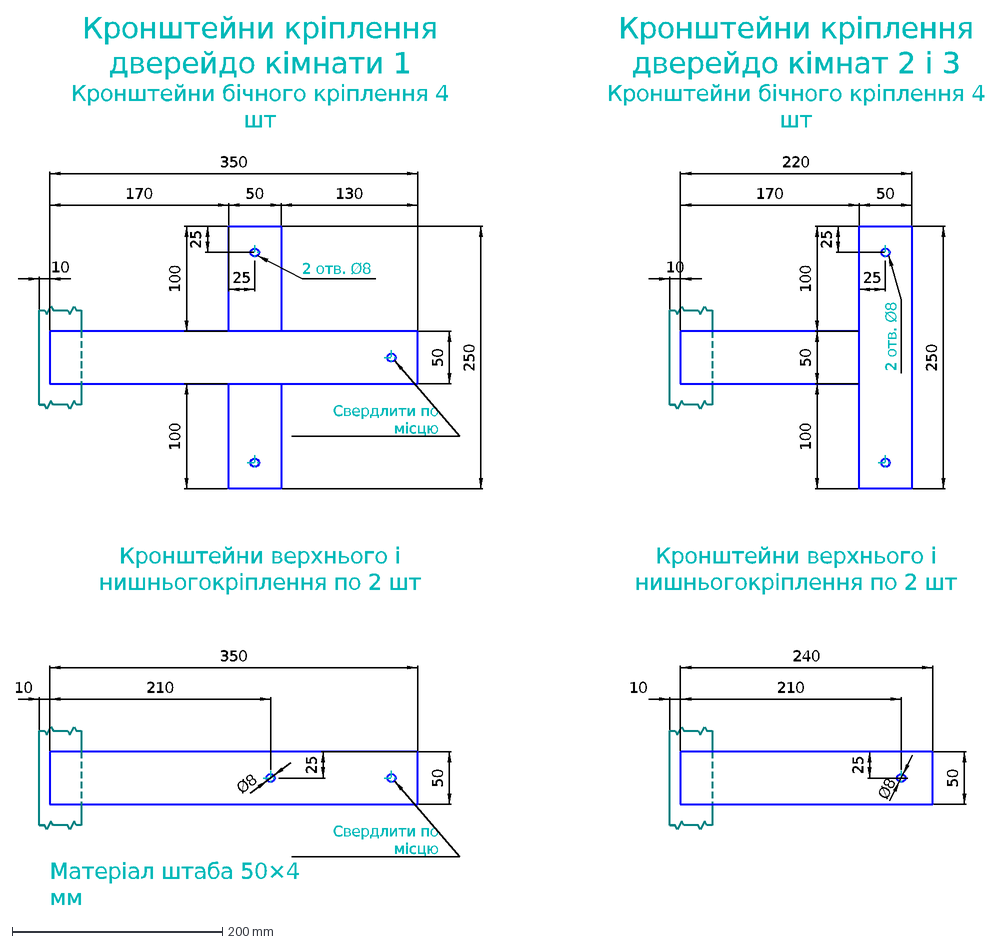
[picture p40: CAD file, 2022-11-16]
sarai_dveri_kimnaty_p3.dxf
50
170
130
350
10
25
100
250
Свердлити по місцю
2 отв. Ø8
220
Кронштейни кріплення дверей до кімнати 1
Кронштейни бічного кріплення 4 шт
210
Ø8
240
Кронштейни верхнього і нишнього кріплення по 2 шт
Кронштейни кріплення дверей до кімнат 2 і 3
Матеріал штаба 50×4 мм
