Butylochnik/Nedra_Sarai/sarai_v1_p19.dxf

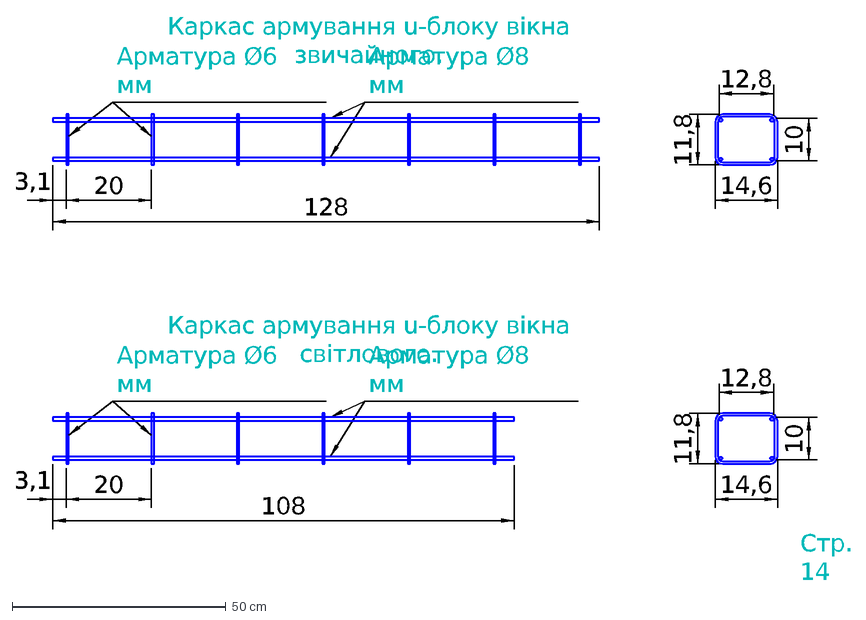
[picture p41: CAD file, 2022-11-16]
sarai_v1_p19.dxf
Стр. 14
10
11,8
14,6
12,8
20
3,1
Арматура Ø6 мм
Арматура Ø8 мм
Каркас армування u-блоку вікна звичайного.
128
108
Каркас армування u-блоку вікна світлового.
