Butylochnik/Nedra_Sarai/sarai_v1_pe.dxf

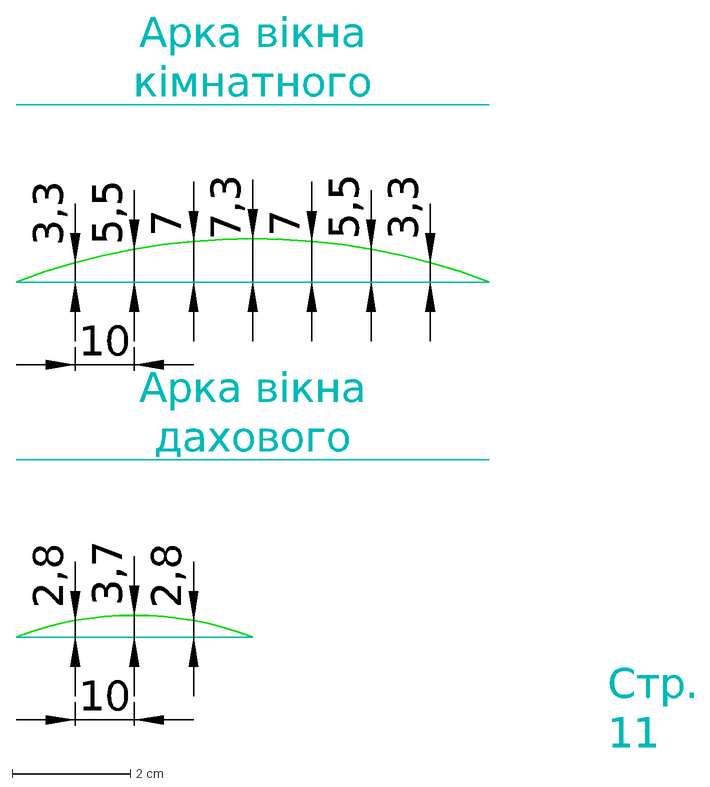
[picture p42: CAD file, 2022-11-16]
sarai_v1_pe.dxf
2,8
3,7
10
Стр. 11
3,3
7,3
7
5,5
Арка вiкна кiмнатного
Арка вiкна дахового
