Butylochnik/Nedra_Sarai/sarai_v1_pa.dxf

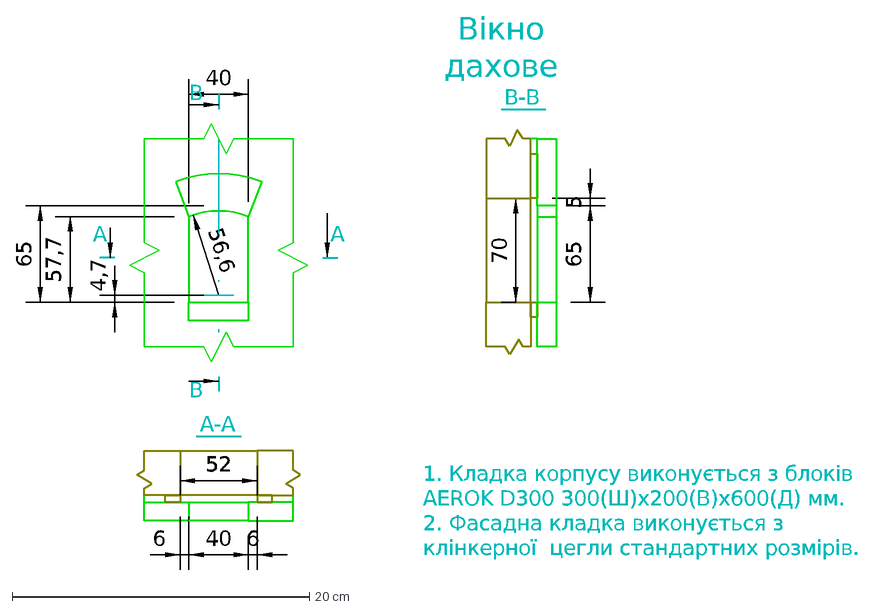
[picture p43: CAD file, 2022-11-16]
sarai_v1_pa.dxf
6
1. Кладка корпусу виконується з блокiв AEROK D300 300(Ш)х200(В)х600(Д) мм. 2. Фасадна кладка виконується з клiнкерної цегли стандартних розмiрiв.
B
A-A
52
40
57,7
70
65
5
56,6
4,7
B-B
Вiкно дахове
A
