Butylochnik/Nedra_Sarai/sarai_v1_p4.dxf

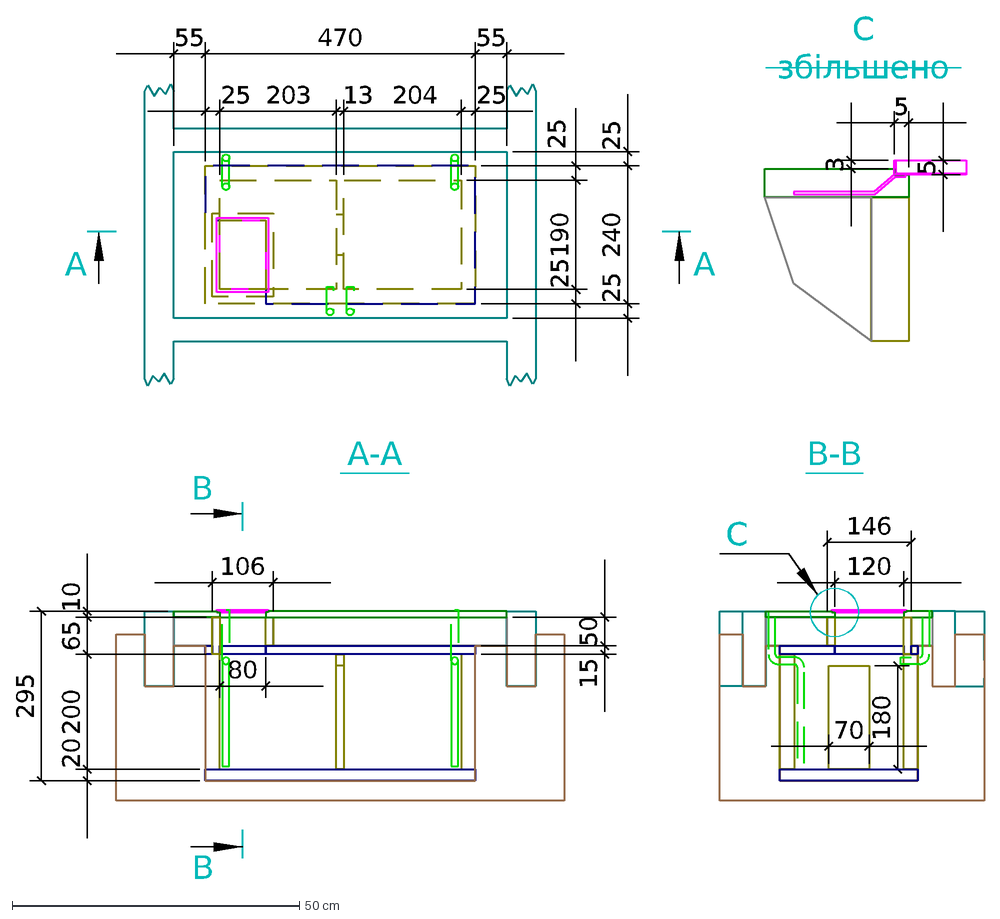
[picture p44: CAD file, 2022-11-16]
sarai_v1_p4.dxf
A
B
25
13
55
470
190
240
10
50
106
203
204
120
146
A-A
C
B-B
3
5
C збiльшено
65
80
295
20
200
15
70
180
