Butylochnik/Nedra_Sarai/sarai_v1_pd.dxf

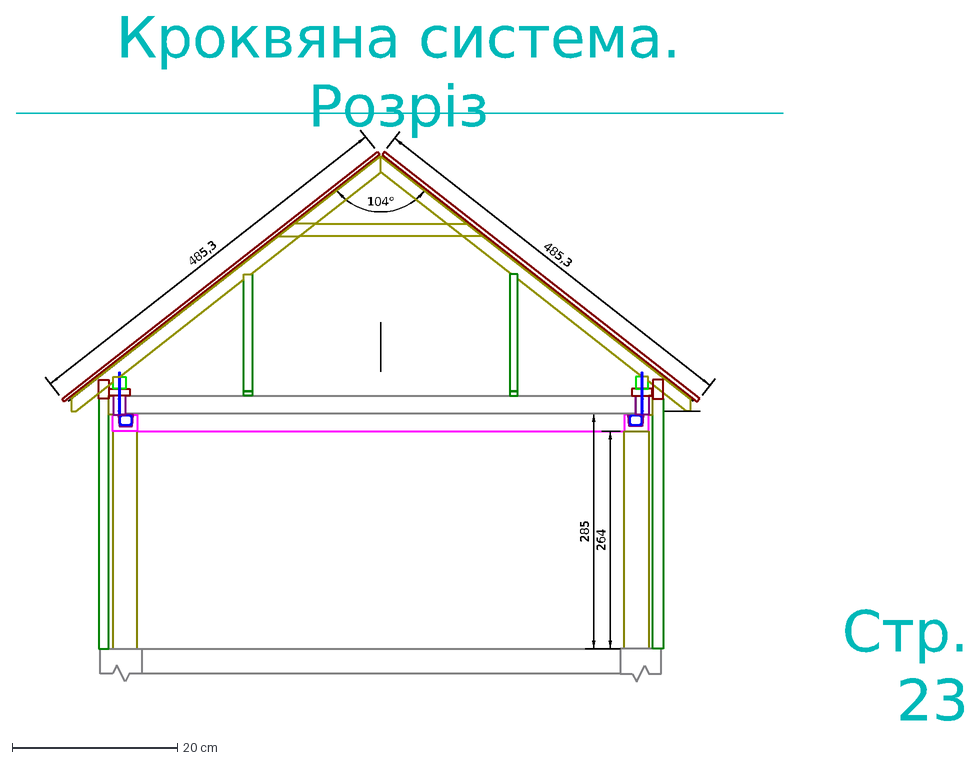
[picture p45: CAD file, 2022-11-16]
sarai_v1_pd.dxf
264
285
485,3
104°
Стр. 23
Кроквяна система. Розріз
