Butylochnik/Nedra_Sarai/sarai_v1_p31.dxf

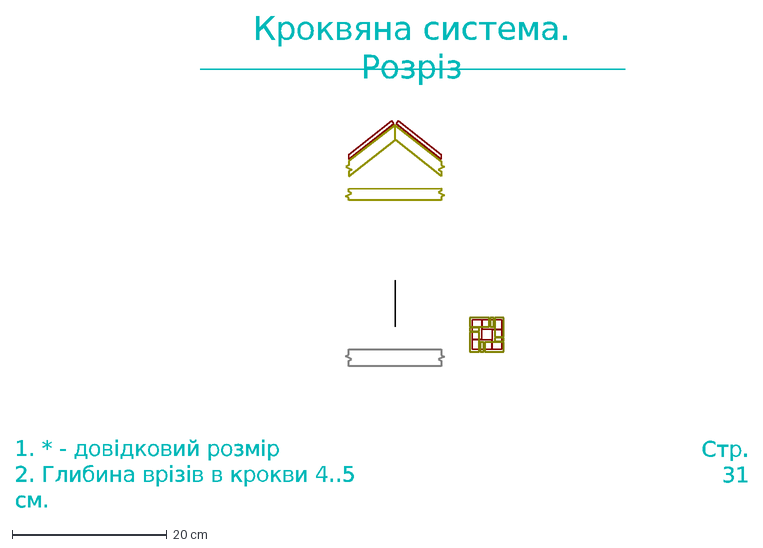
[picture p46: CAD file, 2022-11-16]
sarai_v1_p31.dxf
Кроквяна система. Розріз
1. * - довiдковий розмiр 2. Глибина врізів в крокви 4..5 см.
Стр. 31
