Butylochnik/Nedra_Sarai/sarai_v1_p30.dxf

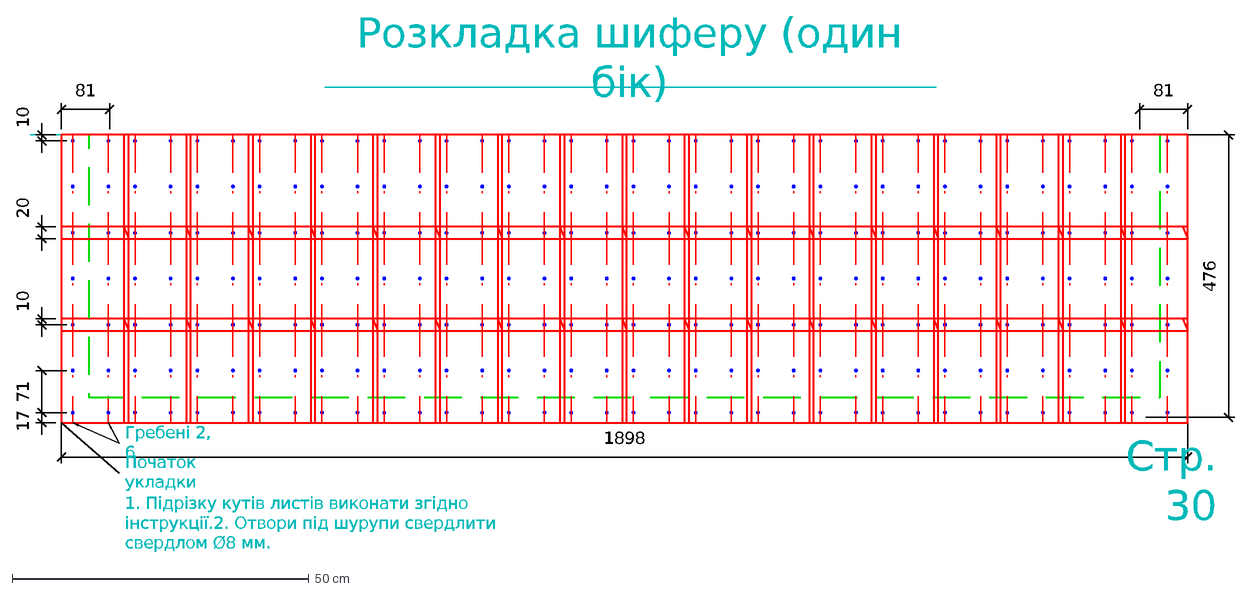
[picture p47: CAD file, 2021-11-07]
sarai_v1_p30.dxf
81
476
1898
Розкладка шиферу (один бік)
Гребені 2, 6
10
Стр. 30
71
17
20
Початок укладки
1. Підрізку кутів листів виконати згідно інструкції. 2. Отвори під шурупи свердлити свердлом Ø8 мм.
