Butylochnik/Nedra_Sarai/sarai_v1_p26.dxf

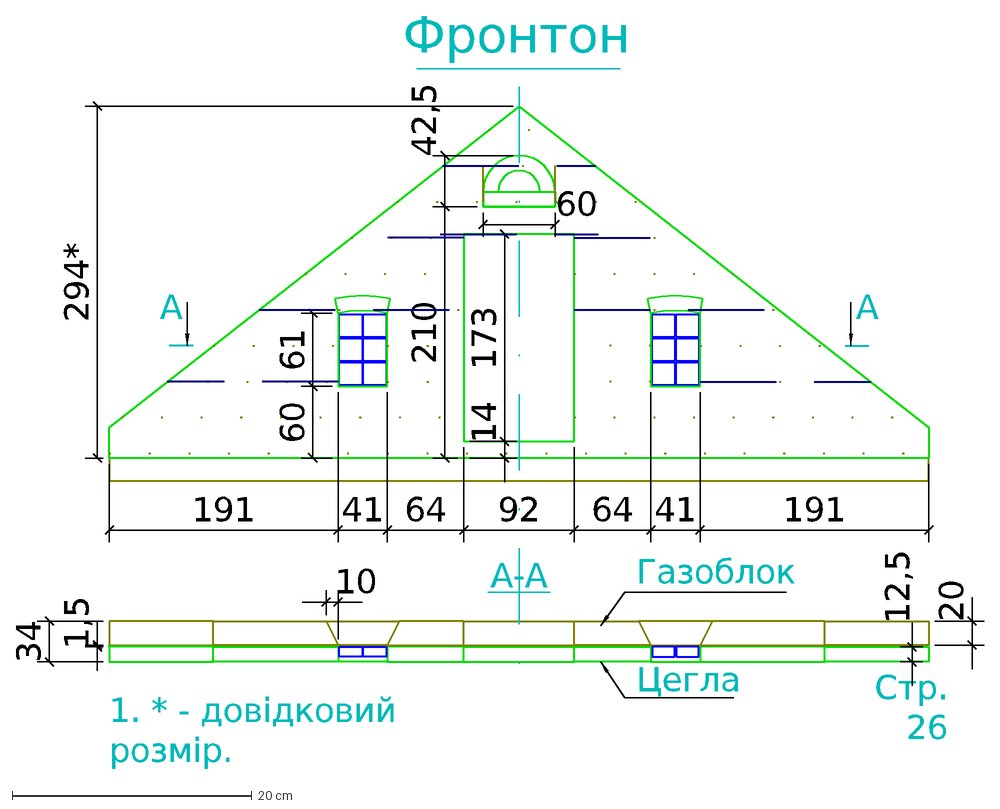
[picture p48: CAD file, 2021-11-07]
sarai_v1_p26.dxf
173
14
210
92
A
294*
A-А
Фронтон
1. * - довiдковий розмiр.
60
191
41
64
61
42,5
10
1,5
34
Стр. 26
Газоблок
Цегла
20
12,5
