Butylochnik/Nedra_Sarai/sarai_v1_p28.dxf

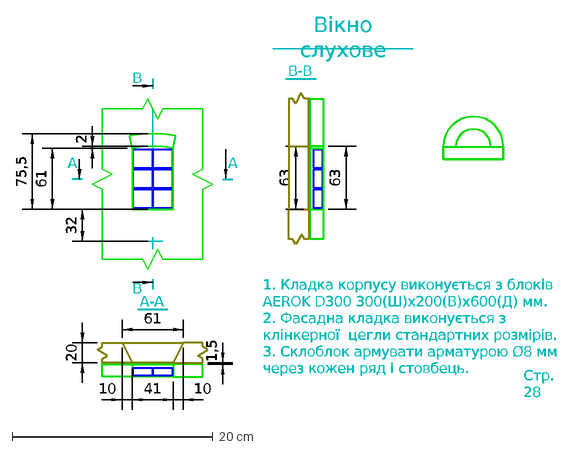
[picture p49: CAD file, 2021-11-07]
sarai_v1_p28.dxf
A
B
32
B-B
20
1,5
61
2
75,5
41
A-A
10
63
1. Кладка корпусу виконується з блокiв AEROK D300 300(Ш)х200(В)х600(Д) мм. 2. Фасадна кладка виконується з клiнкерної цегли стандартних розмiрiв. 3. Склоблок ар
Вiкно слухове
Стр. 28
