Butylochnik/Nedra_Sarai/sarai_v1_p29.dxf

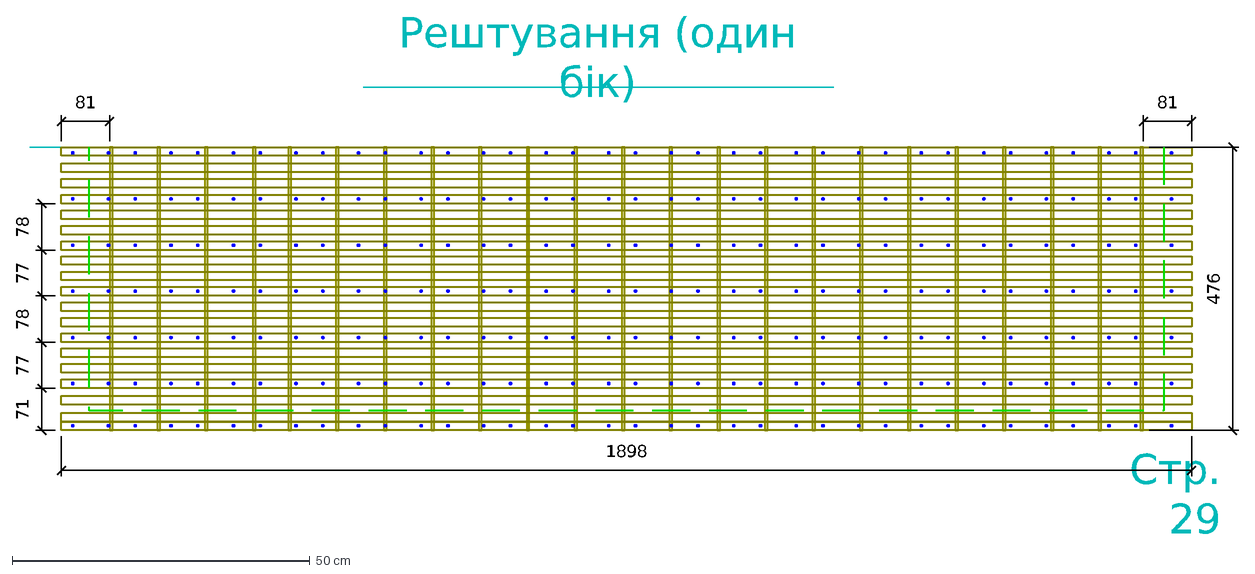
[picture p50: CAD file, 2021-11-07]
sarai_v1_p29.dxf
Стр. 29
81
476
Рештування (один бік)
1898
71
77
78
