Butylochnik/Nedra_Sarai/sarai_v1_p12.dxf

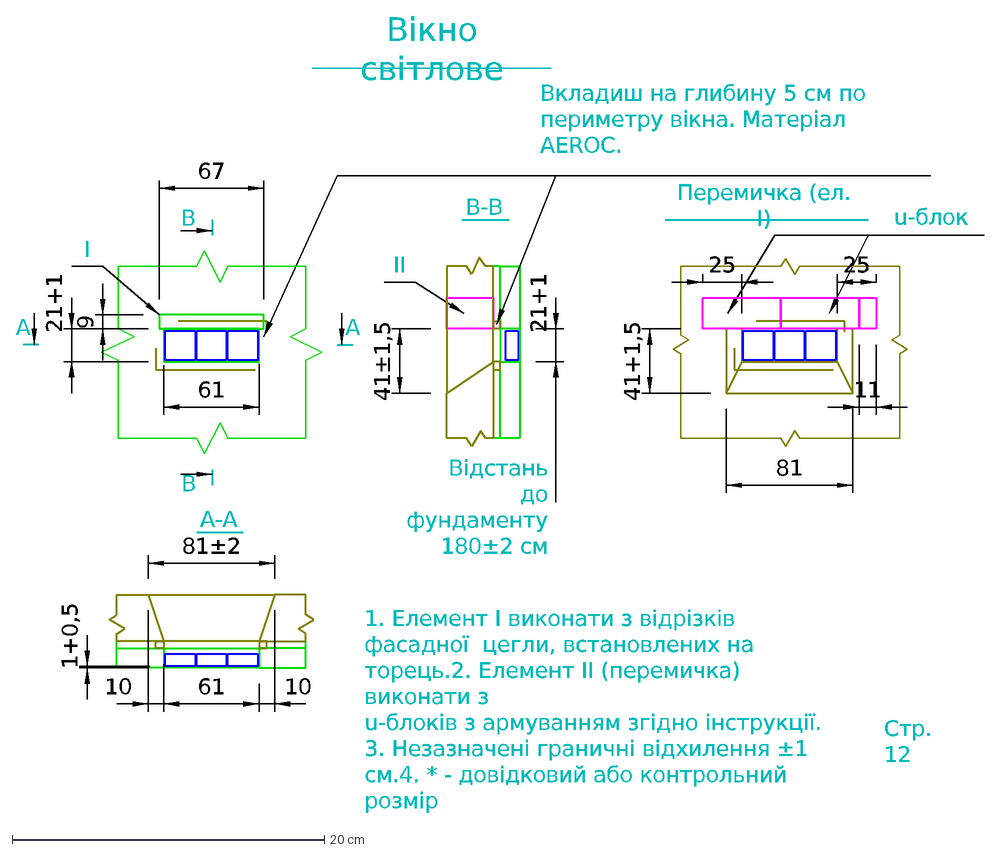
[picture p51: CAD file, 2021-10-23]
sarai_v1_p12.dxf
B-B
Вiкно свiтлове
A
B
21+1
u-блок
Перемичка (ел. I)
61
A-A
1+0,5
Вiдстань до фундаменту 180±2 см
9
67
II
I
1. Елемент I виконати з відрізків фасадної цегли, встановлених на торець. 2. Елемент II (перемичка) виконати з u-блокiв з армуванням згiдно iнструкцiї. 3. Незаз
41±1,5
Стр. 12
81±2
41+1,5
81
10
25
11
Вкладиш на глибину 5 см по периметру вiкна. Матерiал AEROC.
