Butylochnik/Nedra_Sarai/sarai_v1_p25.dxf

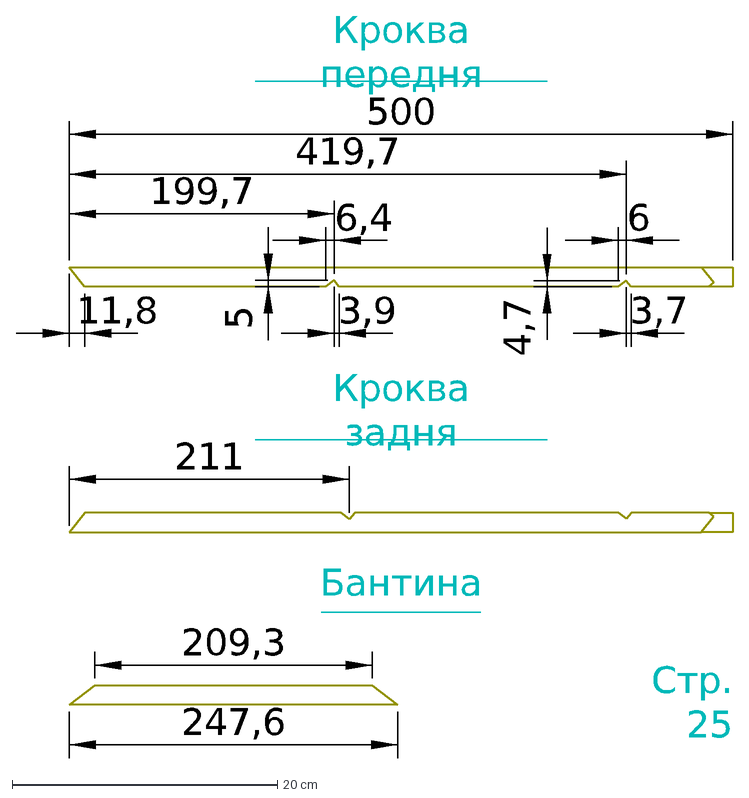
[picture p52: CAD file, 2021-10-23]
sarai_v1_p25.dxf
211
3,9
6,4
3,7
6
11,8
199,7
419,7
500
5
4,7
Кроква передня
Кроква задня
209,3
247,6
Бантина
Стр. 25
