Butylochnik/Nedra_Sarai/sarai_v1_p27.dxf

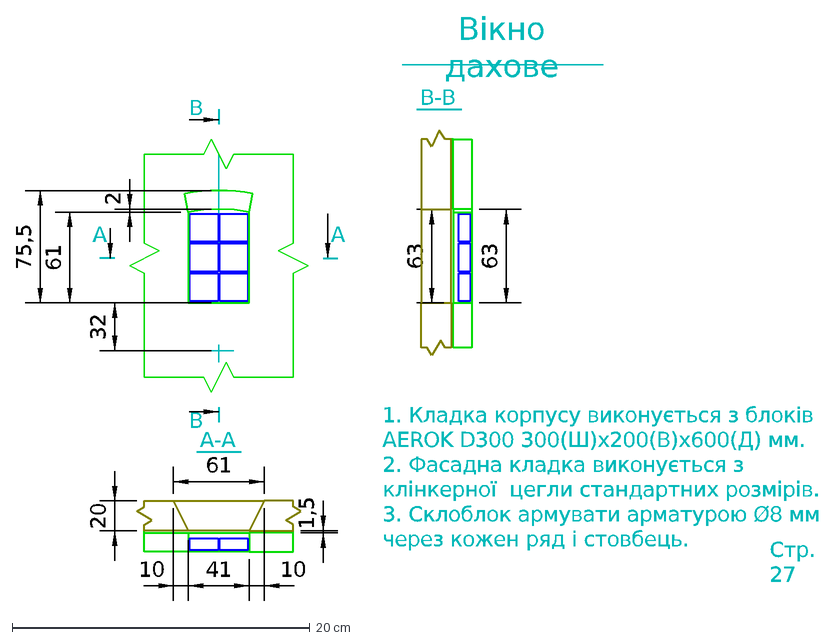
[picture p53: CAD file, 2021-10-23]
sarai_v1_p27.dxf
Вiкно дахове
A
B
32
B-B
20
1,5
Стр. 27
61
2
75,5
41
A-A
10
63
1. Кладка корпусу виконується з блокiв AEROK D300 300(Ш)х200(В)х600(Д) мм. 2. Фасадна кладка виконується з клiнкерної цегли стандартних розмiрiв. 3. Склоблок ар
