Butylochnik/Nedra_Sarai/sarai_v1_p24.dxf

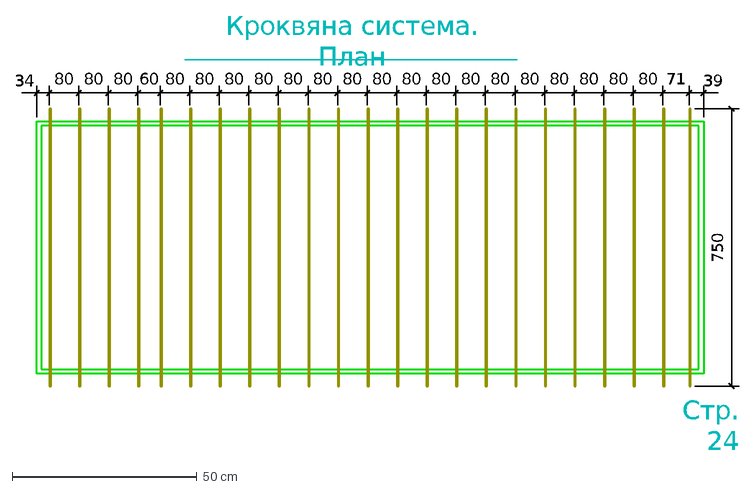
[picture p54: CAD file, 2021-10-23]
sarai_v1_p24.dxf
34
80
60
Кроквяна система. План
71
39
Стр. 24
750
