Butylochnik/Nedra_Sarai/sarai_v1_p9.dxf

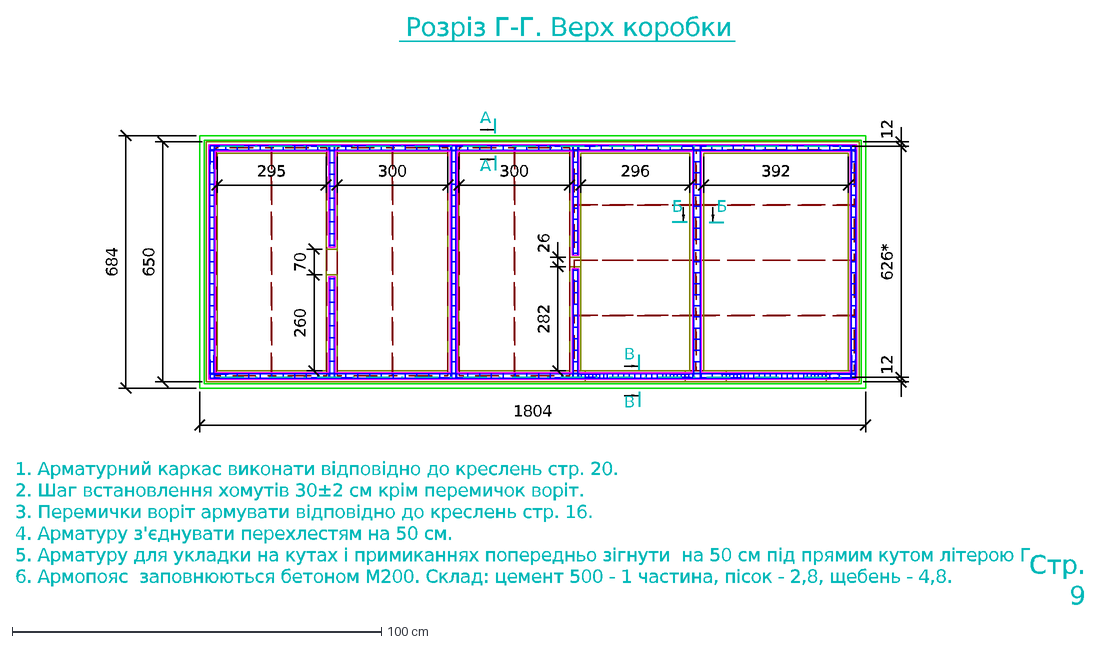
[picture p55: CAD file, 2021-10-11]
sarai_v1_p9.dxf
Розріз Г-Г. Верх коробки
1804
282
26
260
70
Б
В
295
300
A
296
392
684
650
626*
12
1. Арматурний каркас виконати відповідно до креслень стр. 20. 2. Шаг встановлення хомутів 30±2 см крім перемичок воріт. 3. Перемички воріт армувати відповідно д
Стр. 9
