Butylochnik/Nedra_Sarai/sarai_v1_p18.dxf

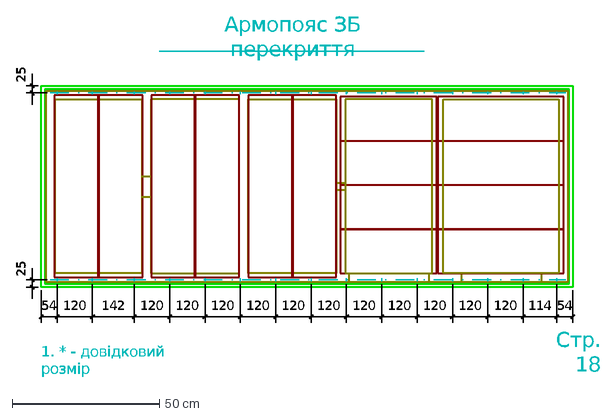
[picture p56: CAD file, 2021-10-11]
sarai_v1_p18.dxf
25
54
120
142
114
Армопояс ЗБ перекриття
1. * - довiдковий розмiр
Стр. 18
