Butylochnik/Nedra_Sarai/sarai_v1_p10.dxf

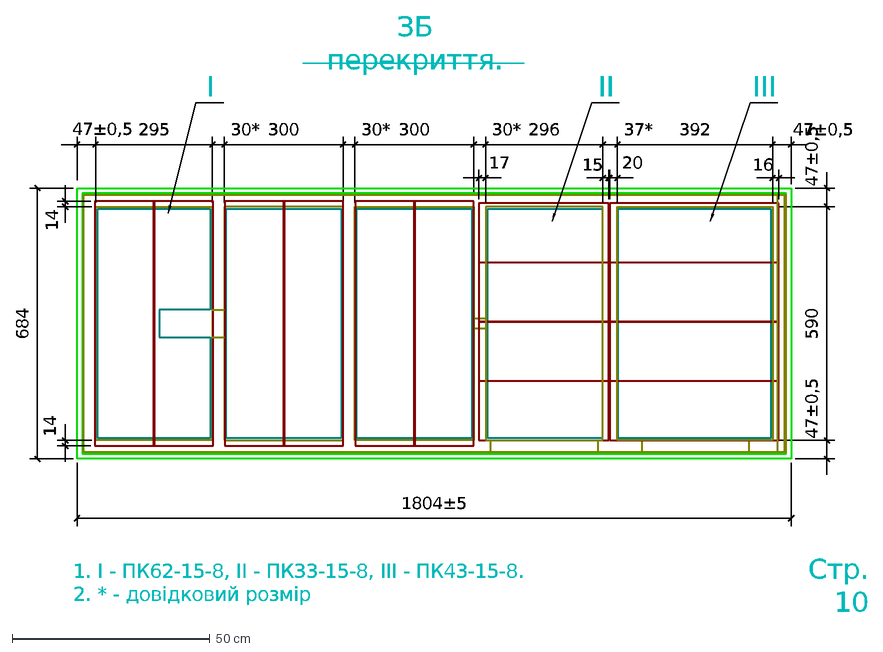
[picture p57: CAD file, 2021-10-11]
sarai_v1_p10.dxf
300
30*
295
684
47±0,5
590
37*
296
392
1804±5
14
17
15
20
16
ЗБ перекриття.
I
II
III
1. І - ПК62-15-8, ІІ - ПК33-15-8, ІІІ - ПК43-15-8. 2. * - довiдковий розмiр
Стр. 10
