Butylochnik/Nedra_Sarai/sarai_v1_p16.dxf

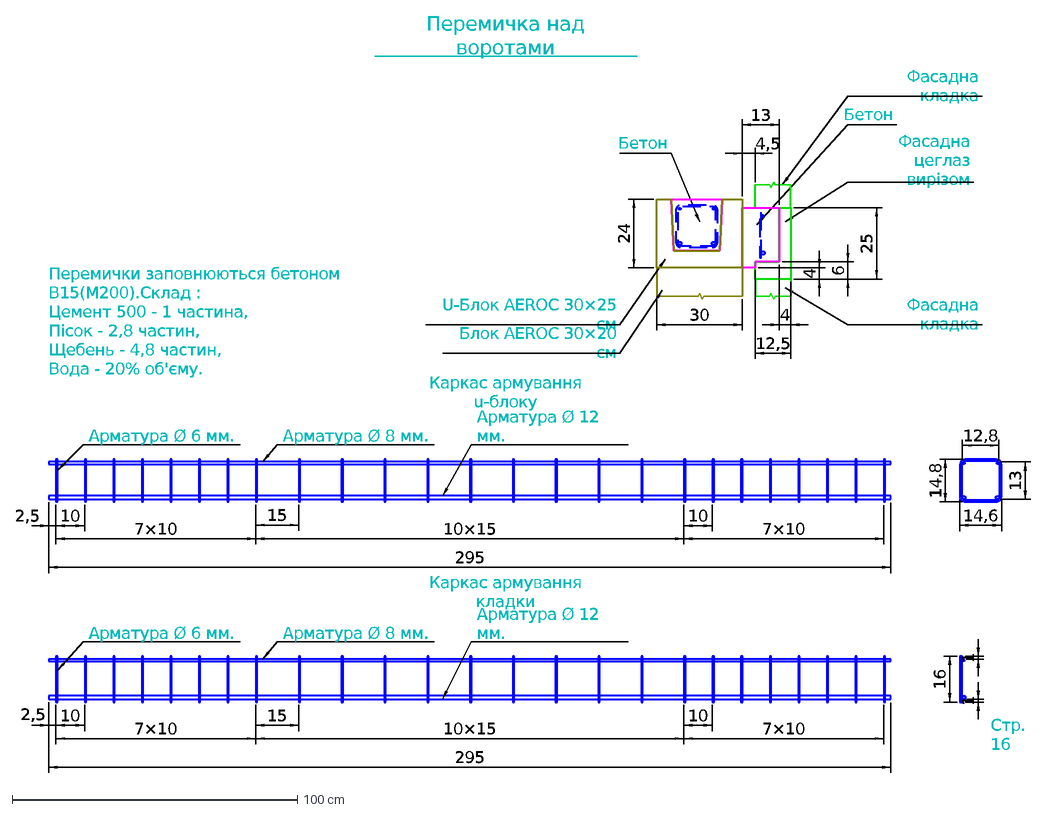
[picture p58: CAD file, 2021-09-20]
sarai_v1_p16.dxf
30
Блок AEROC 30×20 см
U-Блок AEROC 30×25 см
Фасадна кладка
Бетон
Фасадна цегла з вирiзом
25
6
12,5
4
Перемичка над воротами
2,5
10
15
14,6
Каркас армування u-блоку
Каркас армування кладки
16
1
Стр. 16
295
7×10
10×15
Арматура Ø 12 мм.
Арматура Ø 6 мм.
Арматура Ø 8 мм.
Перемички заповнюються бетоном В15(М200). Склад : Цемент 500 - 1 частина, Пісок - 2,8 частин, Щебень - 4,8 частин, Вода - 20% об'єму.
13
4,5
24
12,8
14,8
