Butylochnik/Nedra_Sarai/sarai_v1_p20.dxf

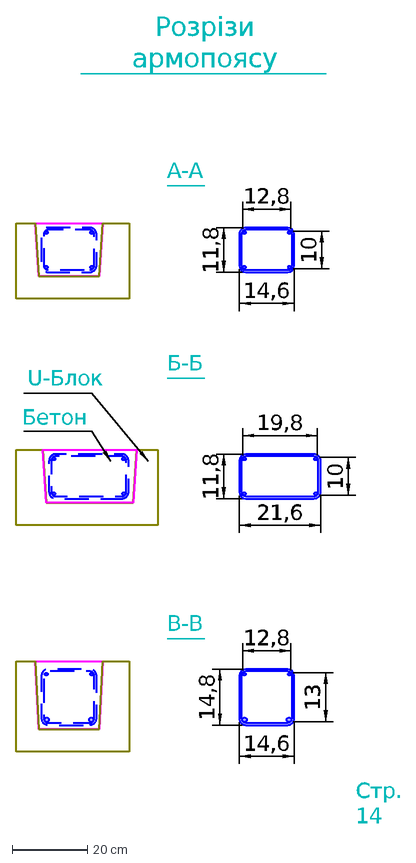
[picture p59: CAD file, 2021-09-20]
sarai_v1_p20.dxf
14,6
12,8
14,8
13
Стр. 14
Розрізи армопоясу
10
11,8
19,8
21,6
Бетон
U-Блок
А-А
Б-Б
В-В
