Butylochnik/Nedra_Sarai/sarai_v1_p17.dxf

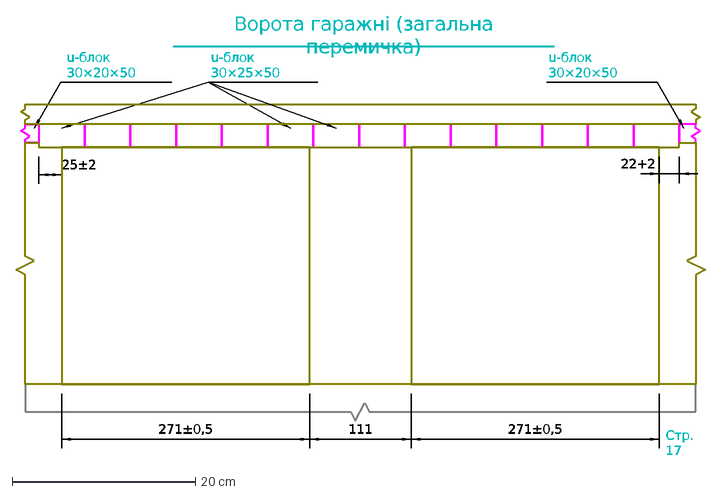
[picture p60: CAD file, 2021-09-13]
sarai_v1_p17.dxf
25±2
u-блок 30×20×50
u-блок 30×25×50
Ворота гаражнi (загальна перемичка)
271±0,5
22+2
111
Стр. 17
