Butylochnik/Nedra_Sarai/sarai_v1_p15.dxf

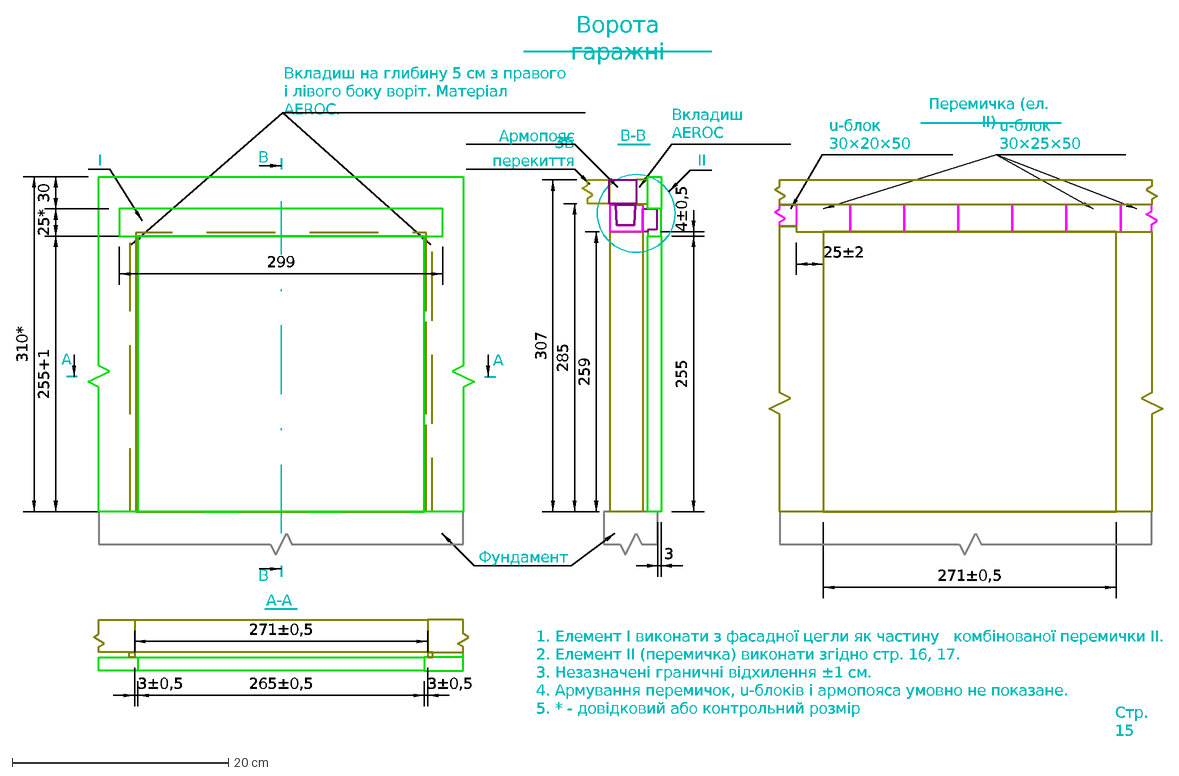
[picture p61: CAD file, 2021-09-13]
sarai_v1_p15.dxf
265±0,5
Фундамент
3±0,5
271±0,5
A
B
A-A
Вкладиш на глибину 5 см з правого i лiвого боку ворiт. Матерiал AEROC.
Ворота гаражнi
I
255+1
3
255
4±0,5
259
25±2
u-блок 30×20×50
u-блок 30×25×50
Перемичка (ел. II)
II
ЗБ перекиття
B-B
25*
299
1. Елемент I виконати з фасадної цегли як частину комбiнованої перемички II. 2. Елемент II (перемичка) виконати згiдно стр. 16, 17. 3. Незазначенi граничнi вiдх
Стр. 15
Армопояс
Вкладиш AEROC
307
285
30
310*
