Butylochnik/Nedra_Sarai/sarai_v1_p21.dxf

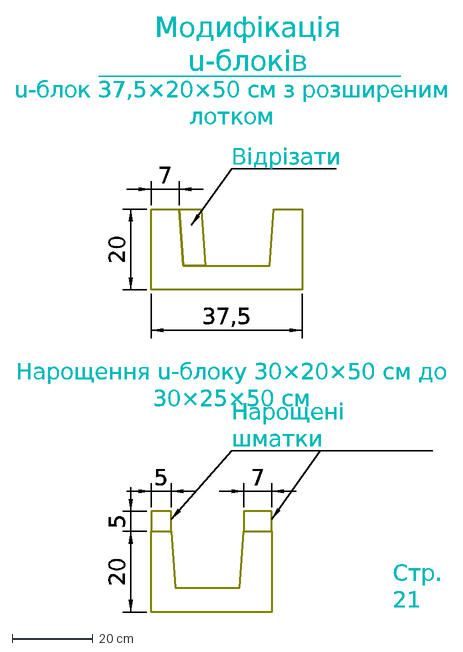
[picture p62: CAD file, 2021-09-13]
sarai_v1_p21.dxf
37,5
20
7
Відрізати
Модифікація u-блоків
u-блок 37,5×20×50 см з розширеним лотком
Нарощення u-блоку 30×20×50 см до 30×25×50 см
Стр. 21
5
Нарощені шматки
