Butylochnik/Nedra_Sarai/arc_construction.dxf

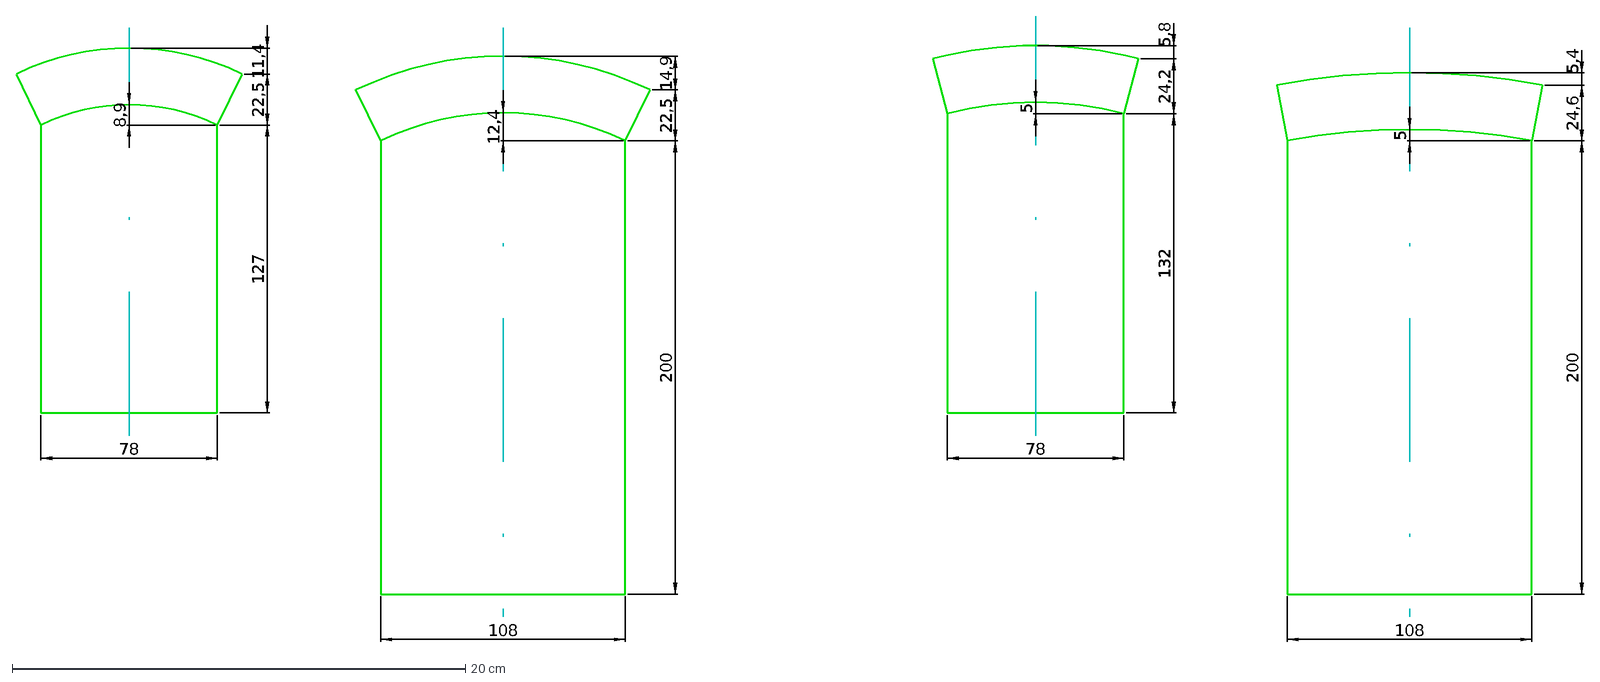
[picture p63: CAD file, 2021-09-03]
arc_construction.dxf
127
78
8,9
22,5
11,4
200
108
14,9
24,6
5,4
12,4
5
132
24,2
5,8
