Butylochnik/Nedra_Sarai/sarai_v1_p14.dxf

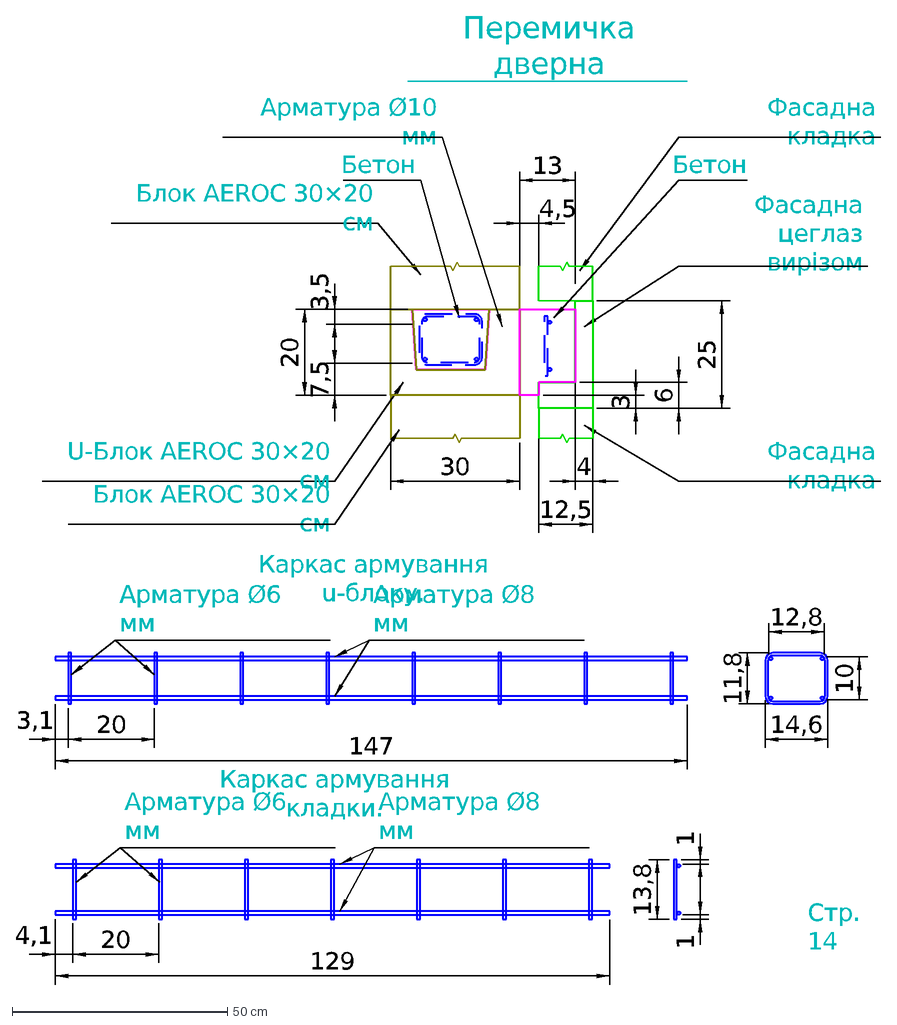
[picture p64: CAD file, 2021-09-03]
sarai_v1_p14.dxf
Перемичка дверна
4
12,5
30
4,5
13
Блок AEROC 30×20 см
Арматура Ø10 мм
Бетон
Фасадна кладка
Фасадна цегла з вирiзом
U-Блок AEROC 30×20 см
25
6
3
7,5
3,5
20
147
3,1
Стр. 14
129
4,1
13,8
1
10
11,8
14,6
12,8
Арматура Ø6 мм
Арматура Ø8 мм
Каркас армування u-блоку.
Каркас армування кладки.
