Butylochnik/Nedra_Sarai/sarai_v1_p11.dxf

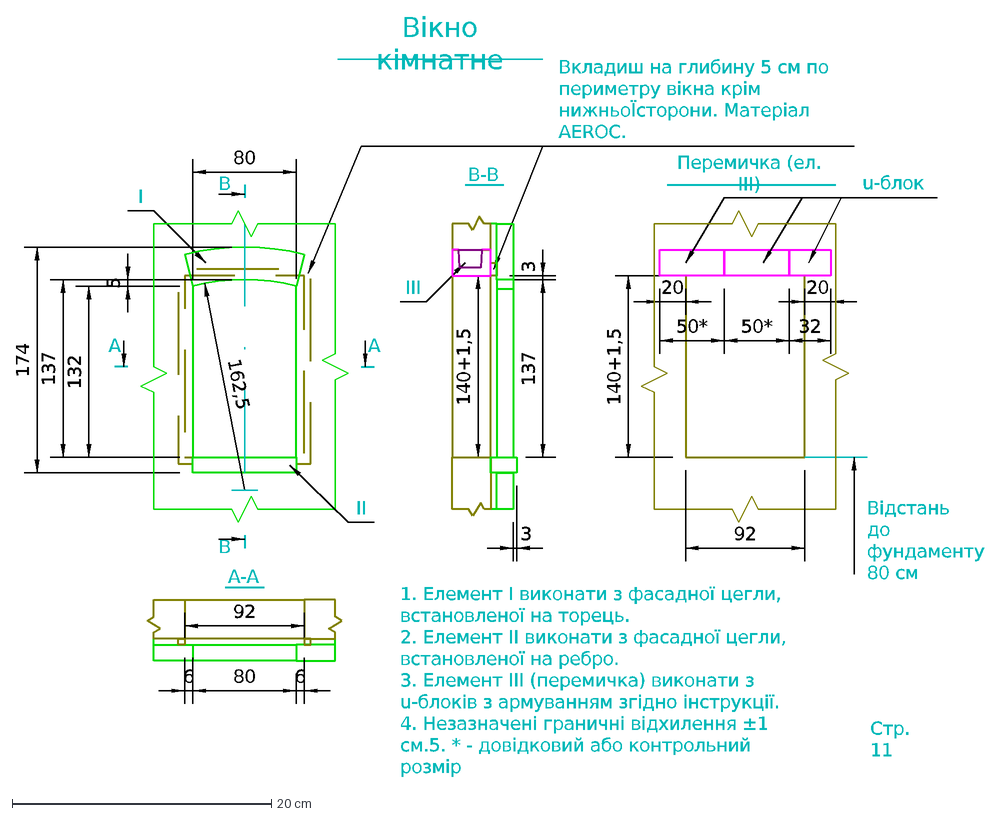
[picture p65: CAD file, 2021-09-03]
sarai_v1_p11.dxf
A
B
I
80
III
Вкладиш на глибину 5 см по периметру вiкна крiм нижньоЇ сторони. Матерiал AEROC.
Вiдстань до фундаменту 80 см
140+1,5
B-B
Перемичка (ел. III)
u-блок
20
50*
32
Вікно кімнатне
137
132
5
174
3
II
162,5
A-A
92
6
1. Елемент I виконати з фасадної цегли, встановленої на торець. 2. Елемент II виконати з фасадної цегли, встановленої на ребро. 3. Елемент III (перемичка) викон
Стр. 11
