Butylochnik/Nedra_Sarai/sarai_v1_pc.dxf

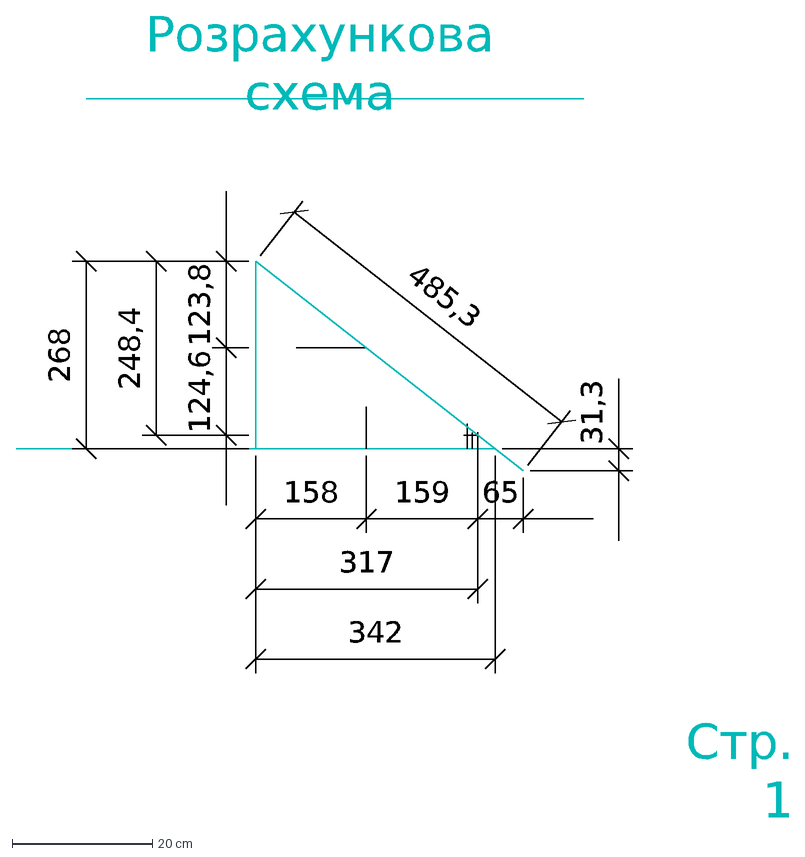
[picture p66: CAD file, 2021-09-03]
sarai_v1_pc.dxf
31,3
485,3
342
317
158
268
248,4
123,8
124,6
159
65
Стр. 1
Розрахункова схема
