Butylochnik/Nedra_Sarai/sarai_v1_p7.dxf

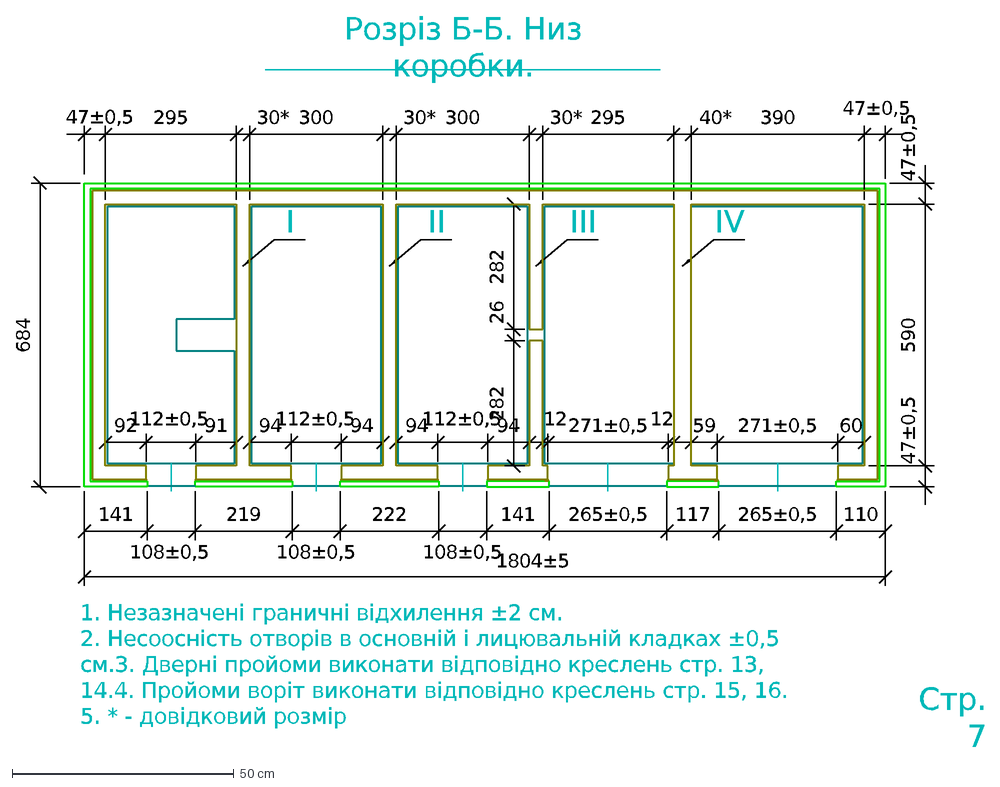
[picture p67: CAD file, 2021-09-03]
sarai_v1_p7.dxf
1. Незазначенi граничнi вiдхилення ±2 см. 2. Несооснiсть отворiв в основнiй i лицювальнiй кладках ±0,5 см. 3. Двернi пройоми виконати вiдповiдно креслень стр. 1
Стр. 7
Розрiз Б-Б. Низ коробки.
I
II
III
IV
300
295
30*
40*
222
141
94
271±0,5
265±0,5
684
390
47±0,5
590
117
59
110
60
219
91
92
112±0,5
12
108±0,5
1804±5
282
26
