Butylochnik/Nedra_Sarai/shablon_vikno_kimnatne.dxf

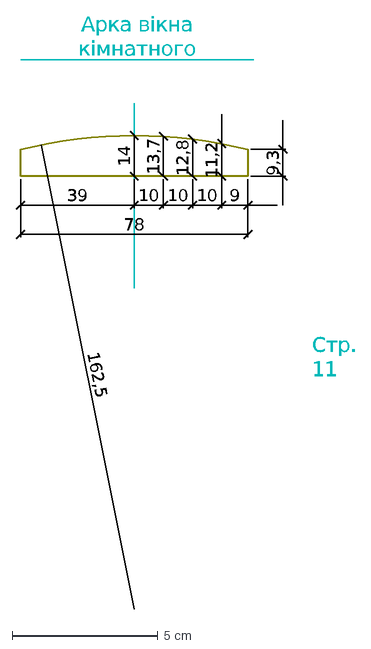
[picture p68: CAD file, 2021-09-03]
shablon_vikno_kimnatne.dxf
Стр. 11
Арка вiкна кiмнатного
39
9
10
78
14
13,7
12,8
11,2
9,3
162,5
