Butylochnik/Nedra_Sarai/sarai_v1_p8.dxf

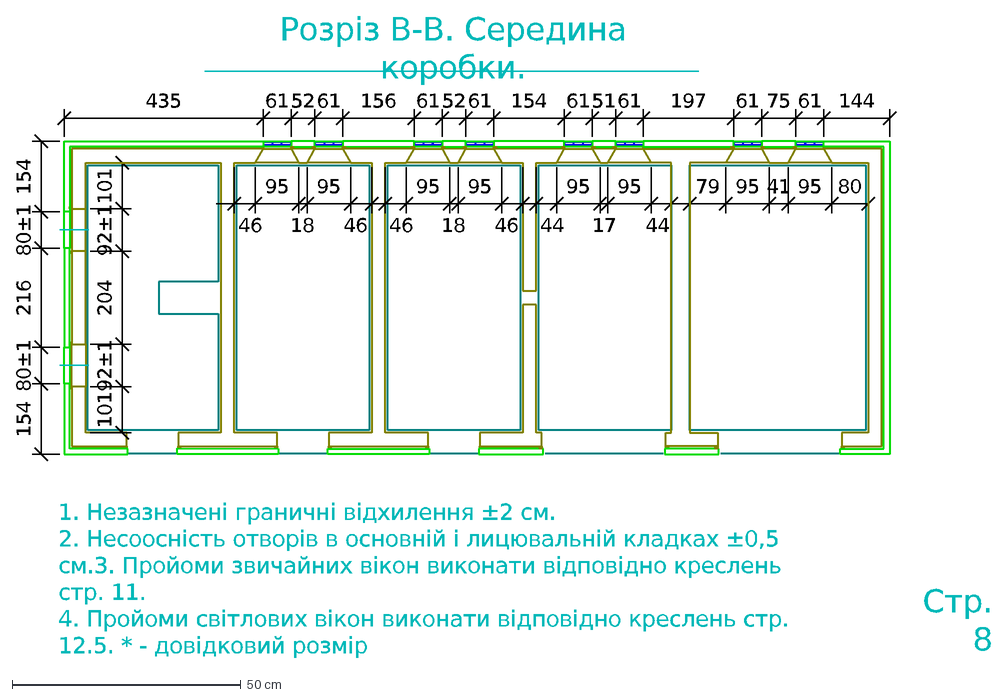
[picture p69: CAD file, 2021-09-03]
sarai_v1_p8.dxf
1. Незазначенi граничнi вiдхилення ±2 см. 2. Несооснiсть отворiв в основнiй i лицювальнiй кладках ±0,5 см. 3. Пройоми звичайних вiкон виконати вiдповiдно кресле
Стр. 8
Розрiз В-В. Середина коробки.
52
51
61
156
154
95
435
80±1
92±1
101
204
216
18
46
44
17
75
197
79
41
144
80
