Butylochnik/Nedra_Sarai/sarai_v1_p1.dxf

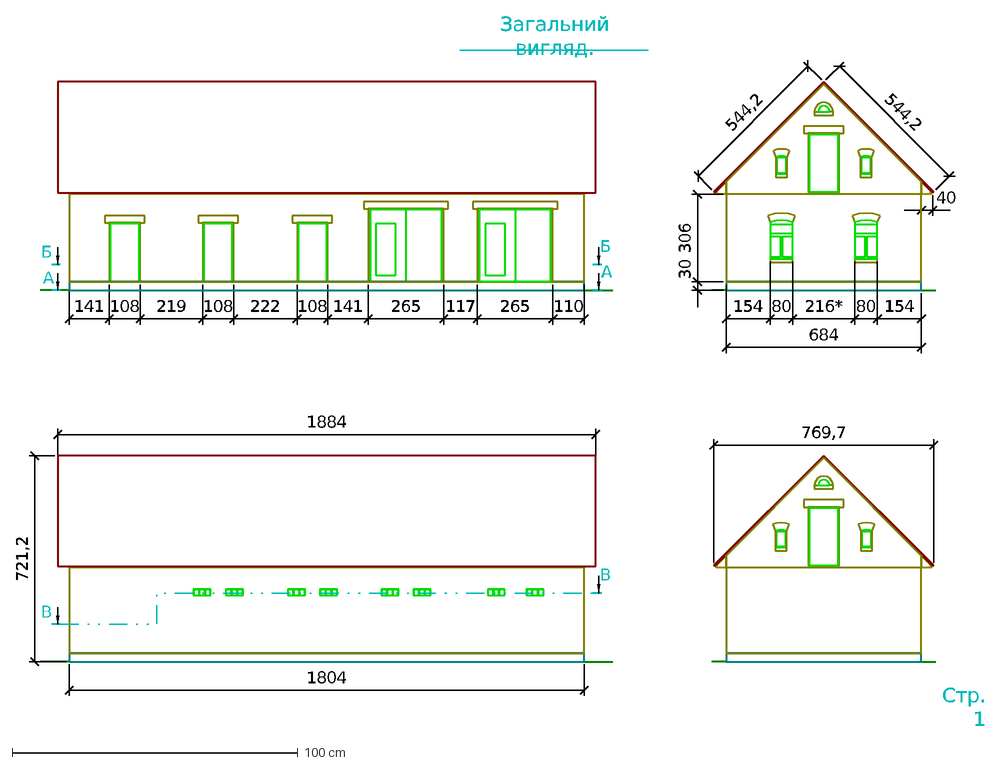
[picture p70: CAD file, 2021-07-29]
sarai_v1_p1.dxf
108
222
141
265
Стр. 1
Загальний вигляд.
Б
А
В
219
1804
117
110
306
30
40
684
769,7
80
154
216*
544,2
721,2
1884
