Butylochnik/Nedra_Sarai/sarai_v1_p5.dxf

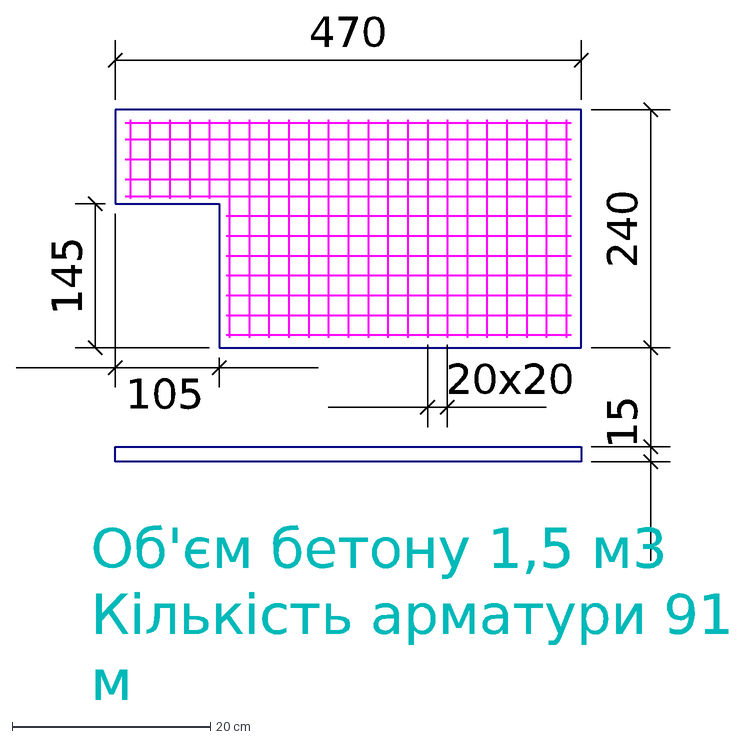
[picture p71: CAD file, 2021-07-24]
sarai_v1_p5.dxf
240
470
145
105
15
20x20
Об'єм бетону 1,5 м3 Кiлькiсть арматури 91 м
