Butylochnik/Nedra_Sarai/sarai_v1_p6.dxf

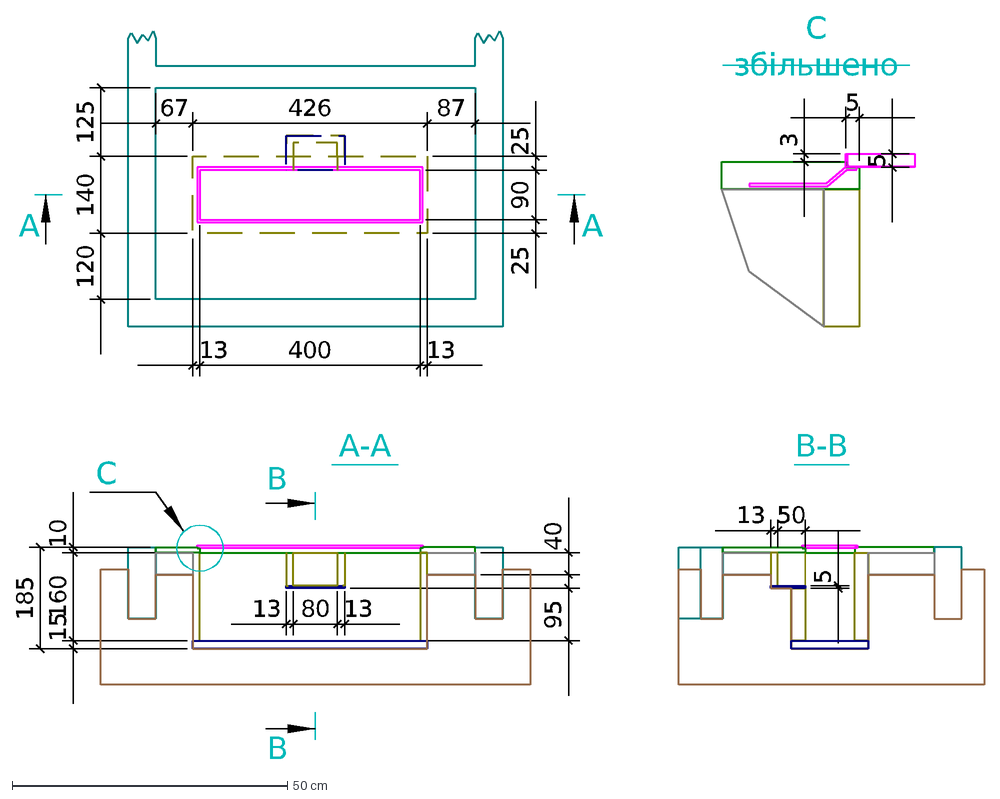
[picture p72: CAD file, 2021-07-24]
sarai_v1_p6.dxf
5
C збiльшено
13
400
67
426
87
120
140
125
90
160
10
95
25
80
40
50
C
B
A-A
B-B
A
3
15
185
