Butylochnik/Nedra_Sarai/sarai_v1_p2.dxf

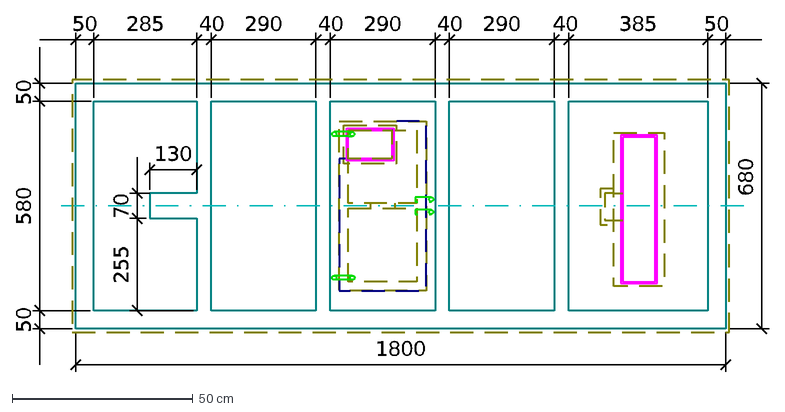
[picture p73: CAD file, 2021-07-24]
sarai_v1_p2.dxf
50
1800
580
285
290
385
40
680
130
70
255
