Butylochnik/Nedra_Sarai/sarai_liuk.dxf

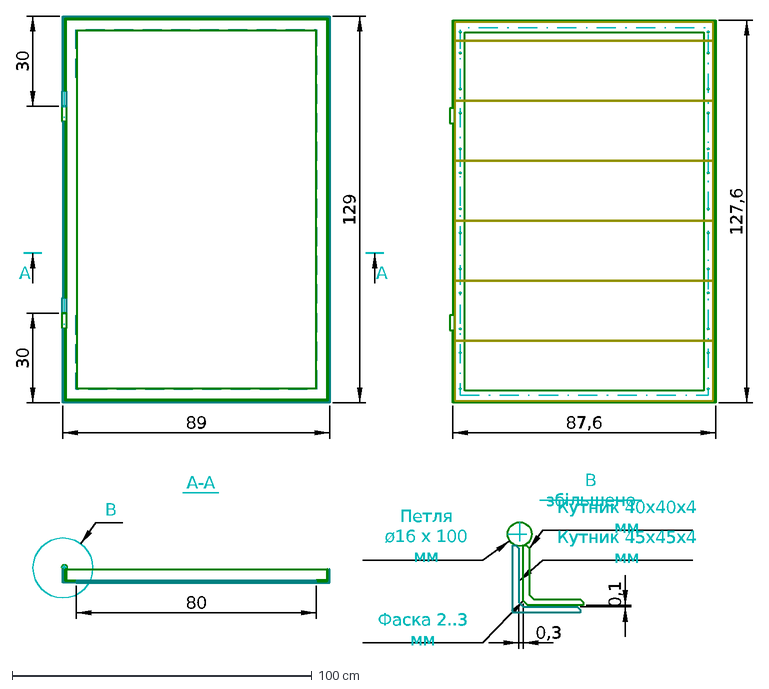
[picture p74: CAD file, 2021-06-11]
sarai_liuk.dxf
A
B
A-A
0,3
Фаска 2..3 мм
30
89
129
80
87,6
127,6
0,1
B збiльшено
Петля ø16 х 100 мм
Кутник 40х40х4 мм
Кутник 45х45х4 мм
