Butylochnik/Nedra_Sarai/ogliad_jama.dxf

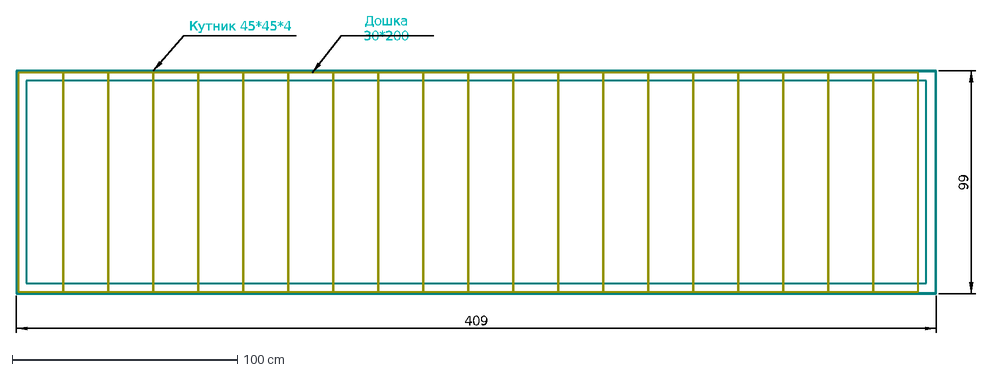
[picture p75: CAD file, 2021-05-05]
ogliad_jama.dxf
409
99
Кутник 45*45*4
Дошка 30*200
