Butylochnik/Nedra_Sarai/(list of files, cad)

Other CAD files:
sarai_vorota_p1.dxf
sarai_vorota_pa.dxf
