Butylochnik/Nedra_Sarai/(commit log)

2020-10-12 Initial commit
    5 кімнат (3, 3, 3, 3, 4), висота 3м, без звісу стін, віконця із
    склоблоку.
    [sarai_v1_p1.dxf, sarai_v1_p2.dxf]
2020-10-16 Changes size of base, adds place for oven
    [sarai_v1_p2.dxf]
2020-10-22 Adds chronicle of building works
    [sarai_v1_p2.dxf]
2020-10-26 adds financial information
    Додав інформацыю про проплату за земляні роботи, покупку арматури.
    [sarai_vytraty.ods]
2020-10-27 Changes orientation of oven place moves wall cut to a new sheet
    [sarai_v1_p3.dxf]
2020-10-27 Changes page layout
    [sarai_v1_p2.dxf]
2020-11-01 Adds information about concreet
    Додав ынформацыю по витратам на арматуру, бетон, бетонны роботи.
    [sarai_vytraty.ods]
2020-11-16 Adds information about formwork.
    Інформація про витрати на опалубку і розрахунок кількості бетону для
    наземної частини.
    [beton_fund_verh.ods, sarai_vytraty.ods]
2020-11-16 Adds contour of cellar and top plates
    [sarai_v1_p2.dxf]
2020-11-19 Adds information about finishing fundament top strip
    Додав інформацію по бетону, фото опалубки, фінансову інформацію по
    опалубці і бетонним роботам.
    [sarai_vytraty.ods]
2021-04-17 Adds cellar scratch and other
    Додав креслення підвалу а також раніше зроблене креслення будинку.
    [saiding_rozrahunok.ods, sarai_v1_p2.dxf, sarai_v1_p3.dxf, sarai_v1_px.dxf, tualet_dah.dxf]
2021-04-17 Adds scratch of cellar top plate
    Креслення верхньої плити підвала, розділеної на 2 частини. Поки не визначився з
    товщиною.
    [sarai_v1_p4.dxf]
2021-04-17 Adds scratch for inspection pit
    Додав креслення оглядової ями.
    [sarai_v1_p2.dxf, sarai_v1_p5.dxf]
2021-04-20 Increases thickness of top and bottom plates
    Збільшив товщину нижньої плити для підвала і оглядової ями до 20 см і 15 см
    відповідно, а верхньої для підвала до 15 см.
    [sarai_v1_p3.dxf, sarai_v1_p5.dxf]
2021-04-21 Adds cellar hatch drawing
    Додав креслення ляди для погреба.
    [sarai_liuk.dxf]
2021-04-21 Adds inspection pit frame
    Додав креслення рамки для оглядової ями.
    [ogliad_jama.dxf]
2021-04-29 Adds finished scratch of cellar top plate
    Креслення верхньої цільної плити підвала. Додав товщину, розрахунок кількості
    бетону і арматури.
    [sarai_v1_p4.dxf]
2021-05-05 Changes one file name, adds concrete volume calculation
    Змінив ім'я файлу з розрахунком кількості бетону і додав у нього нове проміжне
    обчислення.
    [beton_fund_verh.ods, rozrakhunok_beton.ods]
2021-05-05 Removes renamed file
    [beton_fund_verh.ods]
2021-05-05 Adds actualized financial information
    Додав звіт про питрату 30000 грн.
    [sarai_vytraty.ods]
2021-05-14 Adds financial information about utilization of 40000 and paymant for works
    Додав інформацію про використання 40000 грн наданих 03.05.21 а також вартість
    виконаних робіт.
    [sarai_vytraty.ods]
2021-05-18 Adds some financial info and calculation amount of brick
    Додав до витрат вартість металу для ляди і ями. Додав розрахунок кількості цегли
    для погреба і ями.
    [rozrakhunok_beton.ods, rozrakhunok_cegla.ods, sarai_vytraty.ods]
2021-05-28 Adds financial information about bricks and slightly corrected picture of house
    Додав інформацію про покупку цегли і цементу.
    [sarai_vytraty.ods]
2021-05-28 Adds intitial picture of shed and drawing of its doors
    Додав початкову картинку сарая і креслення дверей для кімнат
    [sarai_dveri.dxf]
2021-06-08 Adds financial information about sand, pipes
    Додав інформацію про пісок, труби, додатковий цемент
    [sarai_vytraty.ods]
2021-06-11 Adds concrete estimation for rooms 3 and 5
    Додав розрахунок бетону за розрахунковими розмірами для 3-ї і 5-ї кімнат.
    [rozrakhunok_beton.ods]
2021-06-11 Adds arc calculation page
    Додав сторінку з розрахунком кількості цегли для арки
    [rozrakhunok_cegla.ods]
2021-06-11 Adds corrected cellar hatch drawing
    Підкорегував першу версію люка підвалу.
    [sarai_liuk.dxf]
2021-06-11 Adds cellar hatch based on 45 and 40 corners drawing
    Замінив кутники 50 -> 45, 45 -> 40 і перерахував розміри.
    [sarai_liuk.dxf]
2021-06-16 Adds financial information
    Додав фінансову інформацію про роботи по перекриттю погреба, облаштуванню
    стяжок, необхідні матеріали.
    [sarai_vytraty.ods]
2021-06-29 Adds drawing of place for window
    Додав малюнок посадочного місця під вікна в кімнаті сараю
    [sarai_v1_p_c.dxf]
2021-06-30 Adds drawing of ventilation window
    Додав креслення вентиляційного вікна, заголовок до креслення кімнатного вікна
    [sarai_v1_p_d.dxf]
2021-07-02 Adds limit deviations to wondow drawings
    Додав граничні відхилення до креслень вікон. Переіменував файл креслення дверей.
    [sarai_dveri.dxf, sarai_dveri_kimnaty.dxf, sarai_v1_p1.dxf, sarai_v1_p_c.dxf]
2021-07-24 First version passed to box work
    Перша версія, передана у роботу по коробці.
    [rozrakhunok_balky.ods, rozrakhunok_beton.ods, rozrakhunok_cegla.ods, sarai_dveri_kimnaty.dxf, sarai_v1_p1.dxf, sarai_v1_p11.dxf, sarai_v1_p12.dxf, sarai_v1_p13.dxf]
2021-07-28 Adds financial information related to face bricks
    Додав інформацію по лицбвальній цеглі, доставці, метрерілах для кладки.
    [sarai_vytraty.ods]
2021-07-29 Changes brick overhang to 2 cm
    [sarai_v1_p1.dxf, sarai_v1_p7.dxf, sarai_v1_p8.dxf, sarai_v1_pc.dxf]
2021-07-29 Adds calculation of number of AEROC blocks
    Додав розрахунок кількості блоків AEROC і їх ціни.
    [rozrakhunok_cegla.ods]
2021-08-05 Updates commercial information
    Додав інформацію по AEROC
    [sarai_vytraty.ods]
2021-08-16 Updates financial information
    Додав інформацію про матеріали для кладки, плити.
    [sarai_vytraty.ods]
2021-08-16 Changes arcs for windows
    Замінив арки на вікнах у повну цеглу на пів цегли.
2021-08-25 Update financial information
    Додав інформацію по склоблокам, кладці рядків 17 - 24.
    [sarai_vytraty.ods]
2021-09-03 Adds corrected doors, windows
    Дадав креслення дверей, вікон після узгодження з кладкою.
    Додав креслення залізобетонного перекриття.
    [rozrakhunok_balky.ods, rozrakhunok_cegla.ods, sarai_v1_p10.dxf, sarai_v1_p11.dxf, sarai_v1_p12.dxf, sarai_v1_p14.dxf, sarai_v1_p15.dxf, sarai_v1_p16.dxf]
2021-09-03 Adds changed frame for doors and windows
    Додав змінену конструкцію арматурного каркаса для дверей і вікон.
    Додав розрахунок кількості арматури на перетинки і хомути.
    [arc_construction.dxf, rozrakhunok_armatura.ods, sarai_v1_p14.dxf]
2021-09-13 Adds drawings of door beam and trimming u-blocks
    Додав креслення:
    дверної перемички з арматурним каркасом,
    підрізки u-блоків для широкої стіни і гаражних воріт.
    Оновив аркуш змісту.
    [sarai_v1_p20.dxf, sarai_v1_p21.dxf]
2021-09-13 Adds corrections to drawings of garage gate
    Відкоригував креслення гаражних воріт.
    [sarai_v1_p10.dxf, sarai_v1_p15.dxf, sarai_v1_p16.dxf, sarai_v1_p17.dxf]
2021-09-13 Adds sizes of reinforcement clamps
    Додав таблицю розмірів арматурних хомутів.
    [rozrakhunok_armatura.ods]
2021-09-13 Adds calculations for brick ordering for garage gate
    Додав розрахунки порядовки цегли для гаражних воріт.
    [rozrakhunok_cegla.ods]
2021-09-13 Actualizes financial information
    Додав інформацію по закупці матеріалов в період з 06.09.21 по 09.09.21 (аванс
    5000 грн).
    [sarai_vytraty.ods]
2021-09-20 Updates financial information
    Додав суми за арматуру 6 і 12 мм, резьбові стріжні, останню проплату за фвсадну
    кладку.
    [sarai_vytraty.ods]
2021-09-20 Adds modivied armature clamps
    Змінив розміри хомутів для перемички і широкої перетинки.
    [rozrakhunok_armatura.ods, sarai_v1_p16.dxf, sarai_v1_p20.dxf]
2021-09-27 Updates financial information
    Додав іеформацію про матеріали для армопоясу, плату за кладку рядів 10-14
    газоблоку і заливку армопоясу.
    [sarai_vytraty.ods]
2021-10-06 Updates financial information
    Додав витрати на кран і монтаж перекриттів.
    [sarai_vytraty.ods]
2021-10-11 Updates financial information
    Додав інформацію по закупці цегли, арматури, іншого.
    [sarai_vytraty.ods]
2021-10-11 Updates plate layer and adds positions of studs for fastening the Mauerlat
    Додав положення шпілек для кріплення мауерлата
    [sarai_v1_p10.dxf, sarai_v1_p18.dxf]
2021-10-11 Adds 2 new pages: armobelt construction and rafter system
    [sarai_v1_p22.dxf, sarai_v1_p23.dxf]
2021-10-11 Adds 3 new pages: top of body (p9), armobelt cuts (p22) and rafter system (p23)
    [sarai_v1_p22.dxf, sarai_v1_p23.dxf, sarai_v1_p9.dxf]
2021-10-11 Adds dimensions of yoke in plate armobelt
    [rozrakhunok_armatura.ods]
2021-10-20 Updates financial information
    Додав інформацію по матеріалах і роботах для армопоясу навколо плит.
    [sarai_vytraty.ods]
2021-10-20 Adds rafter system view from top
    Додав сторінку з планом кроквяної системи.
    [sarai_v1_p23.dxf, sarai_v1_p24.dxf]
2021-10-23 Adds fronton drawing, updates rafter system
    Закінчив креслення кроквяної системи, додав креслення фронтону.
    [sarai_v1_p12.dxf, sarai_v1_p24.dxf, sarai_v1_p25.dxf, sarai_v1_p26.dxf, sarai_v1_p27.dxf]
2021-10-26 Updates financial information
    Додав витрати на дерево для даху, оплату кладки під муерлат.
    [sarai_vytraty.ods]
2021-11-07 Updates rafter system, adds slate fitting map, financial update
    Оновив фінансову інформацію, додав розкладку шиферу, відкорегував кроквяну
    систему
    [sarai_v1_p26.dxf, sarai_v1_p28.dxf, sarai_v1_p29.dxf, sarai_v1_p30.dxf, sarai_vytraty.ods]
2021-11-23 Updates financial information
    [sarai_vytraty.ods]
2021-12-01 Updates financial information
    Додав вартісь робіт з монтажу фронтонів, мурлату, кроквяної системи, руберойду і
    шиферу.
    [sarai_vytraty.ods]
2022-06-16 Updates financial information
    Додав інформацію по матеріалам і роботам з виготовлення основи відмостки і
    заїздів у гаражі.
    [sarai_vytraty.ods]
2022-07-31 Updates financial information
    Додав витрати на виготовлення відмостки навколо сараю, заїздів у гаражі, дверях,
    коробці навколо даху.
    [sarai_vytraty.ods]
2022-11-09 Adds fundament drawing and cincrete volume calc
    [budynok_p0.dxf, budynok_p1.dxf, budynok_p2.dxf, rosrakhunok_fundament.ods]
2022-11-11 Updates concrete volume calc
    Оновив розрахунок об'єму бетону для проміжного шару.
    [rosrakhunok_fundament.ods]
2022-11-12 Updates financial info
    [sarai_vytraty.ods]
2022-11-15 Removes dir Bdynok from this repo
    [budynok_p0.dxf, budynok_p1.dxf, budynok_p2.dxf, rosrakhunok_fundament.ods]
2022-11-16 Removes all not related to sarai
    [saiding_rozrahunok.ods, tualet_dah.dxf]
2022-11-16 Moves all files from dir Sarai to root
    [arc_construction.dxf, ogliad_jama.dxf, pechka.dxf, rozrakhunok_armatura.ods, rozrakhunok_balky.ods, rozrakhunok_beton.ods, rozrakhunok_cegla.ods, sarai_dveri_dahovi_p1.dxf]
2022-11-21 Додав звідки витягати код
2023-05-30 Різні дрібні оновлення аркушів
    [sarai_dveri_kimnaty_p1.dxf, sarai_v1_p23.dxf]
2023-06-22 Додав інформацію по сонячних батареях
    [solar_bat_placement.dxf]
2023-07-19 Додав мануал до інвертора з моєю версією прошивки
2023-08-13 Додав інормацію по сонячних батареях
    [sarai_v1_p23.dxf, solar_bat_placement.dxf]
2023-10-23 Видалив непотрібну чернетку гратки вікна
    [sarai_gratka_kimnaty_1.dxf]
2023-12-11 Додав часткове креслення воріт і таблицю з розмірами різних дверей.
    [sarai_rozmir_otvoriv.ods, sarai_vorota_p1.dxf]
2024-02-29 Оновив таблицю розмірів отворів.
    [sarai_dveri_kimnaty_p1.dxf, sarai_rozmir_otvoriv.ods]
2024-02-29 Додав деякі розміри до креслень.
    [sarai_vorota_p1.dxf]
2024-03-10 Додав сторінки з креcленнями засувок.
    [sarai_vorota_p2.dxf, sarai_vorota_p3.dxf, sarai_vorota_p4.dxf]
2024-03-26 Відкоригував і доповнив креслення отворів заскочки і замка дверей.
    [sarai_dveri_kimnaty_p2.dxf]
2024-03-29 Додав креслення отворів під заскочку та замок.
    [sarai_vorota_p5.dxf]
2024-03-29 Додав креслення розкрою листів.
    [sarai_vorota_p6.dxf]
2024-03-29 Відредагував малюнок листів покриття.
    [sarai_vorota_p1.dxf]
2024-04-21 Переніс креслення розкрою листів на окремий аркуш.
    [sarai_vorota_p1.dxf, sarai_vorota_pa.dxf]
2024-04-21 Додав розрахунок підрізки листа.
    [sarai_rozmir_otvoriv.ods]
2024-04-21 Додав креслення кронштейнів кріплення воріт до стін.
    [sarai_vorota_p6.dxf]
2024-04-21 Додав місця встановлення кронштейнів кріплення.
    [sarai_vorota_p1.dxf, sarai_vorota_p6.dxf]
2024-05-09 Додав заготовку креслень вентиляційних проходів.
    [sarai_vorota_p6.dxf, sarai_vorota_p7.dxf]
2024-05-09 Оновив креслення вентиляційної решітки.
    [sarai_vorota_p7.dxf]
2024-06-02 Перемістив місце позначення розміру для нижніх защіпок.
    [sarai_vorota_p2.dxf]
2024-06-09 Додав інформацію про заміну акумулятора.
    Також додав тлумачення параметрів інвертора що впливають на струм заряду
    акумуляторів.
2024-06-14 Перемістив креслення вентрешітки на новий аркуш.
    [sarai_vorota_p8.dxf]
2024-06-14 Додав розташування петель і чернетку збільшиних креслень петель.
    [sarai_vorota_p1.dxf, sarai_vorota_p7.dxf]
2024-07-14 Оновив креслення воріт.
    [sarai_vorota_p1.dxf, sarai_vorota_p5.dxf, sarai_vorota_p7.dxf, sarai_vorota_pa.dxf]
2024-07-17 Додав інформацію про підключення додатково 4х акумуляторів.
2024-12-03 Додав інформацію про розмір рейок для кріплення OSB для воріт.
    [sarai_rozmir_otvoriv.ods]
